benlorenzetti/2015-01-28-Multi-Stage-Tuned-Amplifier/report.pdf

## Multi-Stage Tuned Amplifier

By: Ben Lorenzetti
Team Member: Francois Nyamsi

Project Start Date: January 22, 2015 Report Submission Date: February 8, 2015

## Contents

1 Objective | 1
2 Principles of Operation | 2
3 Theory | 3
4 Design and Simulation | 8
5 Appendices | 12

## 1 Objective

To compare the operation of common-emitter and common-base tuned amplifier stages, and to design and characterize a multi-stage, high-gain IF amplifier for 10 MHz operation with 50Ω input and output impedances.

## 2 Principles of Operation

Tuned amplifiers are critical for electronic communications because they increase the power of desired signal but reject other frequencies as noise. At 10 MHz, a tuned amplifier could be used with an antenna to recieve HF amateur radio from the other side of the world 1
, or
could be used in a computer to recieve 10Base-T ethernet.
There are three possible circuit configurations for bipolar junction transistors (BJT) biased in forward-active mode, based on which terminals are used for input, output, and common reference.

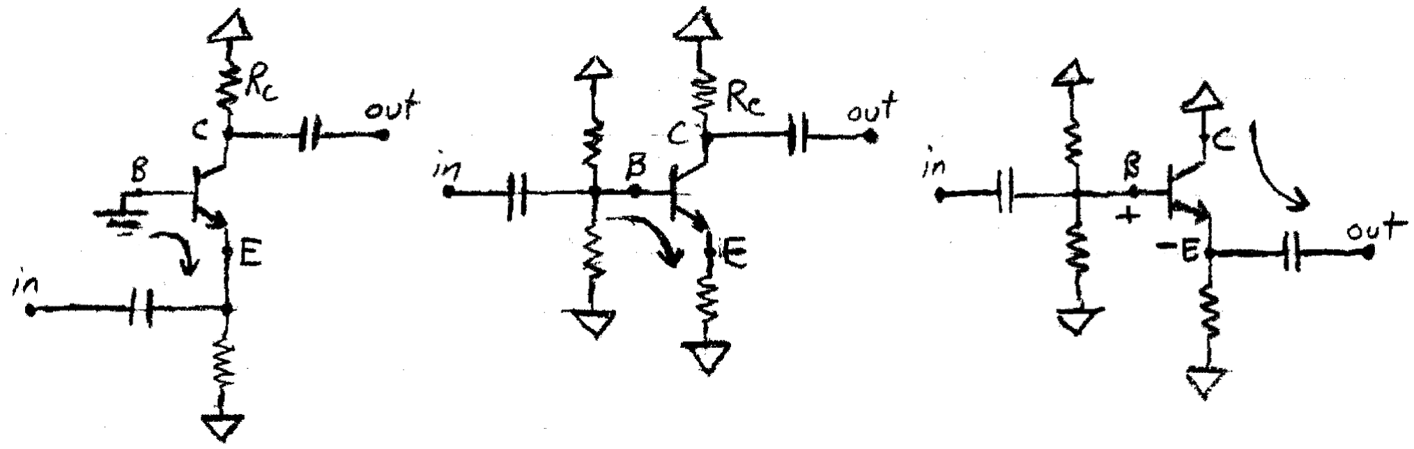
[picture p5: figure]

Figure 1: Common-base (left), common-emitter (middle), and common-collector (right) configurations for BJT amplifiers.

Each configuration has its tradeoffs. The common-base (CB) configuration is a good current buffer, with Ai ≈ 1 and low input impedance. The common-emitter (CE) configuration offers the best overall power gain, but Av and Ai may vary with loadings. The common-collector configuration is a good voltage buffer (Av ≈ 1) with low output impedance.
The three configurations can be cascaded together to gain the benefits of each. If cascaded in the order shown in figure 1, from left-to-right, the resulting 3-stage broadband amplifier would have low input impedance, good power gain, and minimal output impedance.
A slight modification to the CE and CB configurations in figure 1 can apply a filter to the broadband amplifier; tuning the gain to a narrow frequency set by a tank circuit. Because BJTs are minority carrier devices, they act as current amplifiers without being strongly affected by voltage. For the two configurations where the output is at the collector (CB and CE), the BJT acts like a dependent current source feeding the output load and the biasing resistance RC. As a result, the voltage gain for these configurations is determined primarily by how difficult it is for the collector current to reach ground; Av ∝ RC||RL. One can take advantage of the collector current’s obstinance by replacing RC with an impedance that varies with frequency. Using an inductor and a capacitor in parallel provides a short circuit to ground for both DC and high frequency currents. Additionally, at the LC circuit’s resonant frequency, the net impedance → ∞ due to power oscillating between the two. 2 The result is a narrow bandpass filter at the resonant frequency, where ZC → ∞.

1
10 MHz waves can traverse the curve of the earth because they get reflected by charged particles in the ionosphere, called ionospheric skip propagation.
2For this reason, an L||C circuit is called a tank circuit.

## 3 Theory

### 3.1 Tank Circuits

No inductor is ideal. The quality of an inductor is defined by the ratio of the impedance and resistance of the discrete element.

Q =

XL
RS

where ZL = RS + jXL

The series resistance RS is due to the resistivity of the wire and the length used to wrap the coil. Furthermore, the impedance XL is not 100% inductive; there is a distributed capacitance CD between the surfaces of the tightly wrapped wire. The circuit model for an inductor is shown in the left pane of figure 2.
As a consequence of the distributed capacitance, every inductor will have a self resonant frequency f0, at which the energy entering the tank will oscillate between the inductor and capacitor instead of passing through.

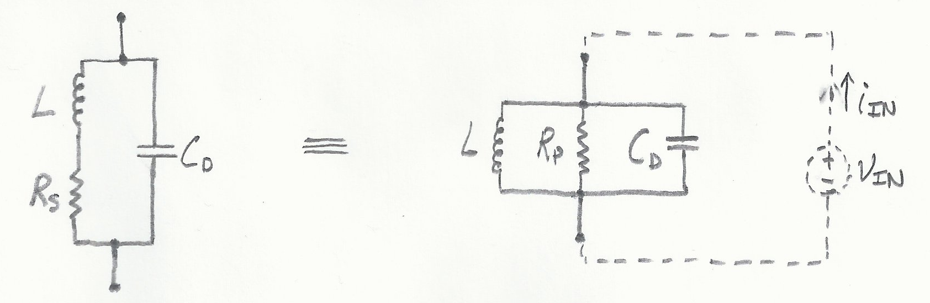
[picture p6: figure]

Figure 2: Circuit model for a non-ideal inductor (left) and its parallel equivalent circuit (right).

Sometimes the parallel equivalent of the imperfect L model is more convenient. If the quality is greater than 5 the conversion is easy:

Q =

XL
RS

=

RP
XL

(1)

The self resonance frequency occurs when the net impedance is greatest. Applying Kirchoff’s current law to the parallel model...

|Iin| =

|Vin|
q
(jωL + 1/jωC)

2 + R²
P

|ZL| =

s
R²
P −
ωL −

1

ωC 2
(2)

One can see that ZL will reach its peak when:
ωL −

1

ωC
= 0

Therefore, the maximum impedance of a tank circuit is:

|ZL|max = RP | when | f0 =

1
2π

√
LC

(3)

More generally than non-ideal inductors; the resonant frequency, bandwidth, and quality of a parallel RLC circuit are related to L, C, and R.

Q =

ω0
B
| = ω0RC = | R ω0L
(4)

### 3.2 Common-Base Broadband Amplifier

The basic circuit for an single stage, common-base (CB) amplifier is shown in figure 3. The base terminal is grounded and the input signal passes through the BJT from emitter to collector. In this configuration, the BJT acts like a current buffer, where the input current is repeated at the output regardless of the load.

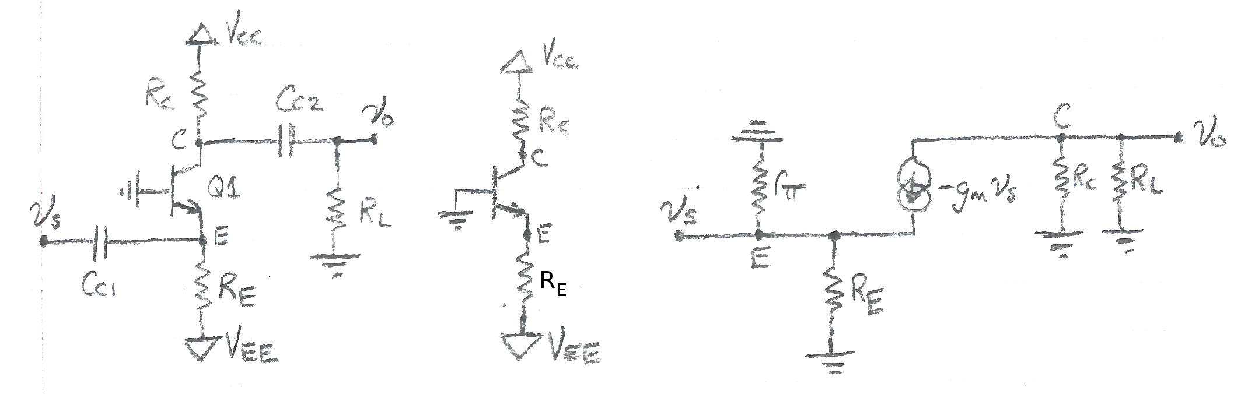
[picture p7: figure]

Figure 3: Basic circuit for a common-base broadband amplifier (left), its DC large signal (middle) equivalent, and AC small signal equivalent (right).

Two DC power rails are needed to bias the BJT in forward-active mode. A positive supply holds the collector reverse biased relative to the base which, at ground, is forward biased relative to the negative supplied emitter. Quiescent point analysis of the common-base is easy because the voltage is pinned at every node.

IEQ =

−VBE(on) − VEE
RE

(5)

rπ =

Vth

IBQ

=

(β + 1)Vth

IEQ

(6)

gm =

β
rπ

=

αIEQ

Vth

(7)

The hybrid-π model for small signal AC modeling is shown in the right pane of figure
3. Applying Kirchoff’s current law at node E can be used to find the input resistance.

KCL @ E: iS −

vs
rπ

−

vs
RE

− gmvs = 0

is = vs

1
Rπ

+

1
RE

+ gm

is = vs

RE + rπ + gmrπRE
rπRE

vs
is

=

rπRE
RE + rπ + gmrπRE

Rin =

rπ
β + 1 + rπ
rE

Rin =

rπ

β + 1
1

1 + rπ/(β+1)RE

(8)

Applying KCL at the collector can be used to calculate the voltage gain of a single common-base stage.

KCL @ C: gmvs +

vo
RL

+

vo
RC

= 0

vo

RL + RC
RLRC
= gmvs

Av =

gmRLRC
RL + RC

(9)

### 3.3 Common-Emitter Broadband Amplifier

The basic circuit for an single stage, common-emitter (CE) amplifier is shown in figure 4. The DC equivalent circuit is shown in the left pane of figure 5; the AC in the right.

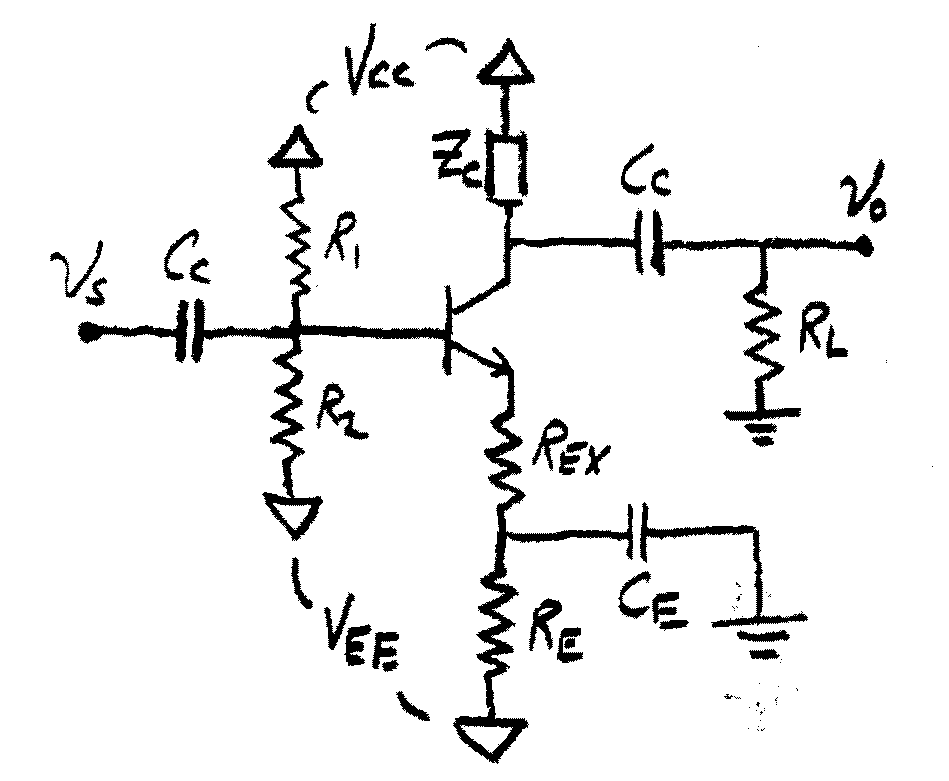
[picture p8: figure]

Figure 4: Broadband Common-Emitter Stage

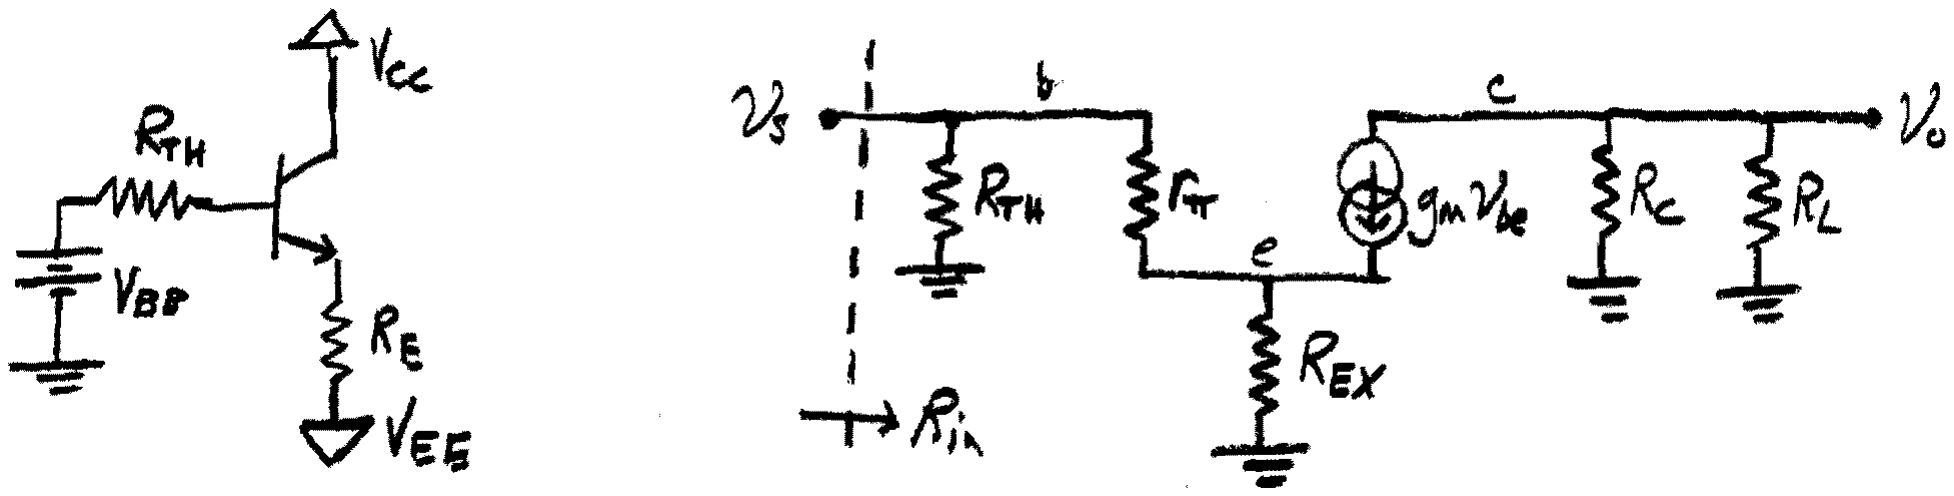
[picture p9: figure]

Figure 5: Common-emitter equivalent circuits: DC (left), AC (right).

The DC equivalent circuit, shown in figure 5, used a thevenin source conversion from the base bias resistors R1 and R2. The thevenin equivalent’s parameters are found by

RT H = R1||R2 =

R1R2
R1 + R2

(10)

and
VBB = VEE +

R2
R1 + R2
(VCC − VEE) | (11)

The same thevenin conversion was used for the AC circuit in figure 5 for RT H. The other parameters in the AC equivalent circuit come from the hybrid-π model, defined previously in equations 6 and 7.
The DC loading characteristics are easily found by using KVL on the collector-emitter loop.

VCC − VCE − REIEQ − VEE = 0

IE =

VCC − VEE
RE

−

VCE
RE

(12)

The AC characteristics require a little more algebra. We are interested in the small signal voltage gain and input resistance for a CE stage. Kirchoff’s current law at the emitter node of the AC equivalent circuit (figure 5, right pane) can be written:

ve − vs
rπ

+

ve

REX

+ gm(ve − vs) = 0

Collecting terms and separating variables gives:

ve

1
rπ

+

1

REX

+ gm

= vs
1
rπ

+ gm

Multiplying both sides by rπ and REX gives:

ve[REX(1 + β) + rπ] = vs(1 + β)REX

So the ratio between ve and vs is:

ve
vs

=

(1 + β)REX
(1 + β)REX + rπ

Looking ahead, in the interest of saving paper, it would be better to have an expression for vs − ve as a function of vs.

vs − ve = vs

1 −

ve
vs
= vs
1 −

(1 + β)REX
(1 + β)REX + rπ

vs − ve =

rπ
(1 + β)REX + rπ
vs | (13)

The small signal voltage gain can be found from Ohm’s law, applied across the resistors between the output and ground.

vo = (RC||RL) ∗ gm(vs − ve)

Substituting equation 13 for the voltage difference and then recognizing that rπgm = β...

vo = (RC||RL)

β
(1 + β)REX + rπ
vs

Dividing both sides by vs and pulling α out of the bracket gives us the magnitude of the transfer function in generic form.

Av =

(RC||RL)

REX

∗

β
β + 1

∗

1

1 + rπ/(β+1)REX

(14)

Now for the small-signal input resistance; the ratio between vs and is in for the AC equivalent circuit in figure 5. Writing KCL at the base node yields

−is +

vs

RT H

+

vs − ve
rπ

= 0

Substituting equation 13 for vs−e eliminates ve

is =

vs

RT H

+

vs
rπ
rπ
(1 + β)REX + rπ

Dividing both sides by vs gives the input conductance, but the partial fractions must be prepared for inversion.

Gin =

1

RT H

+

1
(1 + β)REX + rπ
=
(1 + β)REX + rπ + RT H
RT H(REX(1 + β) + rπ)

Inverting the conductance and pulling (1 + β)REX + rπ out of both numerator and denominator gives the input resistance in generic form.

Rin = RT H
1

1 + RTH/(1+β)REX+rπ

If one assumes that RT H >> (1 + β)REX + rπ, then the +1 term in the denominator is negligible and the input resistance simplifies to

Rin = (1 + β)REX + rπ | (15)

### 3.4 Voltage Gain and IEQ

Substituting equation 7 for gm into equation 9 gives voltage gain of a CB amplifier as a function of quiescent current. Similaryly, substituting equation 6 for rπ into equation 14 gives the small-signal gain of a CE amplifier.

Av(CB) =

α(RL||RC)IEQ

Vth

(16)

Av(CE) =

α(RC||RL)

REX
1

1 + Vth/REXIEQ
(17)

Using typical resistor values, the small-signal gain of broadband common-base and common-emitter amplifiers was plotted as a function of DC biasing. The MATLAB script used to generate plot 6 is included in appendix 5.3.

Figure 6: Relationship Between AC Voltage Gain and DC Biasing for CB and CE Amplifier

### 3.5 Coupling Capacitors

The coupling capacitors, labeled CCx, isolate each stage from direct currents but provide a low impedance path for the AC signal. Taken together, they should form a sharp high-pass filter with its corner frequency below 1000 Hz. The 3dB corner occurs when half the signal power is dissipated in the capacitor and half in the stage’s input. This occurs when ZCc = Zin.

1
|jωC|

= Rin

CC ≥

159.15 µF ∗ Ω

Rin

(18)

## 4 Design and Simulation

### 4.1 Specifications

The multi-stage amplifier must meet the following specifications in table 1.

Table 1: Lab Specifications

power supply | ±12V
passband center frequency | 10MHz
bandwidth | 300kHz
input impedance | 50Ω
ouptut impedance | 50Ω
gain at center frequency | > 60dB

### 4.2 BJT Characterization

Four npn 2N2904 BJTs were characterized using the Tektronix curve tracer and an HP LCR meter. The results are shown in table 2. The current amplification factors (β or hfe) were taken with DC biasing close to their designed use; the actual IC − VCE characteristic curves appear later, as the DC design is described.

Table 2: Measured BJT Characteristics

| Q1 | Q2 | Q3 | Q4
β | 181 | 191 | 189 | 189
VA | 260V | 273V | 273V | 224V

CCB

3 | 5.1pF | 5.19pF | 5.18pF | 5.23pF
CBE | 3.26pF | 3.28pF | 3.30pF | 3.24pF

### 4.3 Tank Circuits

Two inductors were wound with ˜22 turns. Their inductance and quality were measured using a Hewlett-Packard 4342A Q Meter. An appropriate discrete capacitor and trimming capacitor were selected for both to obtain a tank circuit with resonance at 10 MHz. The fixed capacitors were soldered to their inductors in parallel.
The soldered LC circuit were breadboarded in parallel with a trimming capacitor and tuned. Then, the breadboarded tank circuit was measured for net capacitance, resonance frequency, and quality using the HP Q Meter. The methods for these measurements are attached in appendix 5.1 and the results are shown in table 3.

Table 3: Tank Circuit Design and Measured Characteristics

Parameter | 1 | 2 | Description
L | 4.2µH | | measured inductor
QL | | | on HP Q Meter
Ctarget | 90 | | from eq. 3.1
Cf ixed | 33pF | | nominal value
Ctrim | 5 − 35pF | | approx. range
Cd | 55pF | | measured LC circuit
f0 | 13.3MHz | | on HP Q Meter,
Q | 85.5 | | see 5.1
Rp | 30kΩ | | from eq. 4

### 4.4 Common-Base Stage

The first stage must be a common-base amplifier in order to achieve low input resistance. The emitter resitance must be chosen to achieve desirable input resistance and voltage gain.

3measurement taken at 10MHz

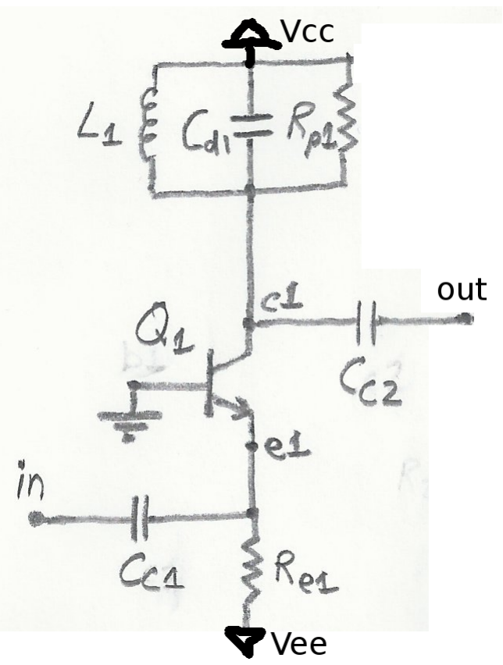
[picture p10: figure]

Figure 7: Common-base stage with SPICE netlist labels.

It is clear that Rin is strongly related to rπ from equation 8. Substituting equation ?? for rπ into equation 8 yields

Rin =

−VthRE

VBE(on) + VEE

or
RE =

Rin(−VBE(on) − VEE)
Vth |

Using the specified value for VEE and Rin, and typical values for Vth and VBE(on) , the
emitter resitance should be

RE =

50Ω(−0.7V + 12V )
0.0259V

= 21.8kΩ

With RE, the quiescent current can be calculated with equation 5; IEQ = 0.52mA. The first BJT was characterized and a DC load line drawn. Because all of the node voltages are pinned, the load line is vertical; VCE is independent of IEQ. It was found that

βQ1 = 176 | VAQ1 = 452V

From equation 18 and using Rin = 50Ω,

CC1 ≥ 3.183pF

At this point, all of the discrete components for the CB stage have been determined. A SPICE simulation was performed to check the performance of the stage. For a load value, the input resistance of the first common emitter stage was used. The netlist used is included in appendix 5.2 and the results are shown in figure 9.

### 4.5 Common-Emitter Stage

The common-emitter configuration provides the highest overall power gain, compared to CB and CC. This makes it ideal for the middle stages. A single CE stage is shown in figure ??.
The second BJT was characterized on the Tektronix Curve Tracer using a range of 20V and 2mA (the maximum swing would actually be 24V). The i-v characteristics and the DC

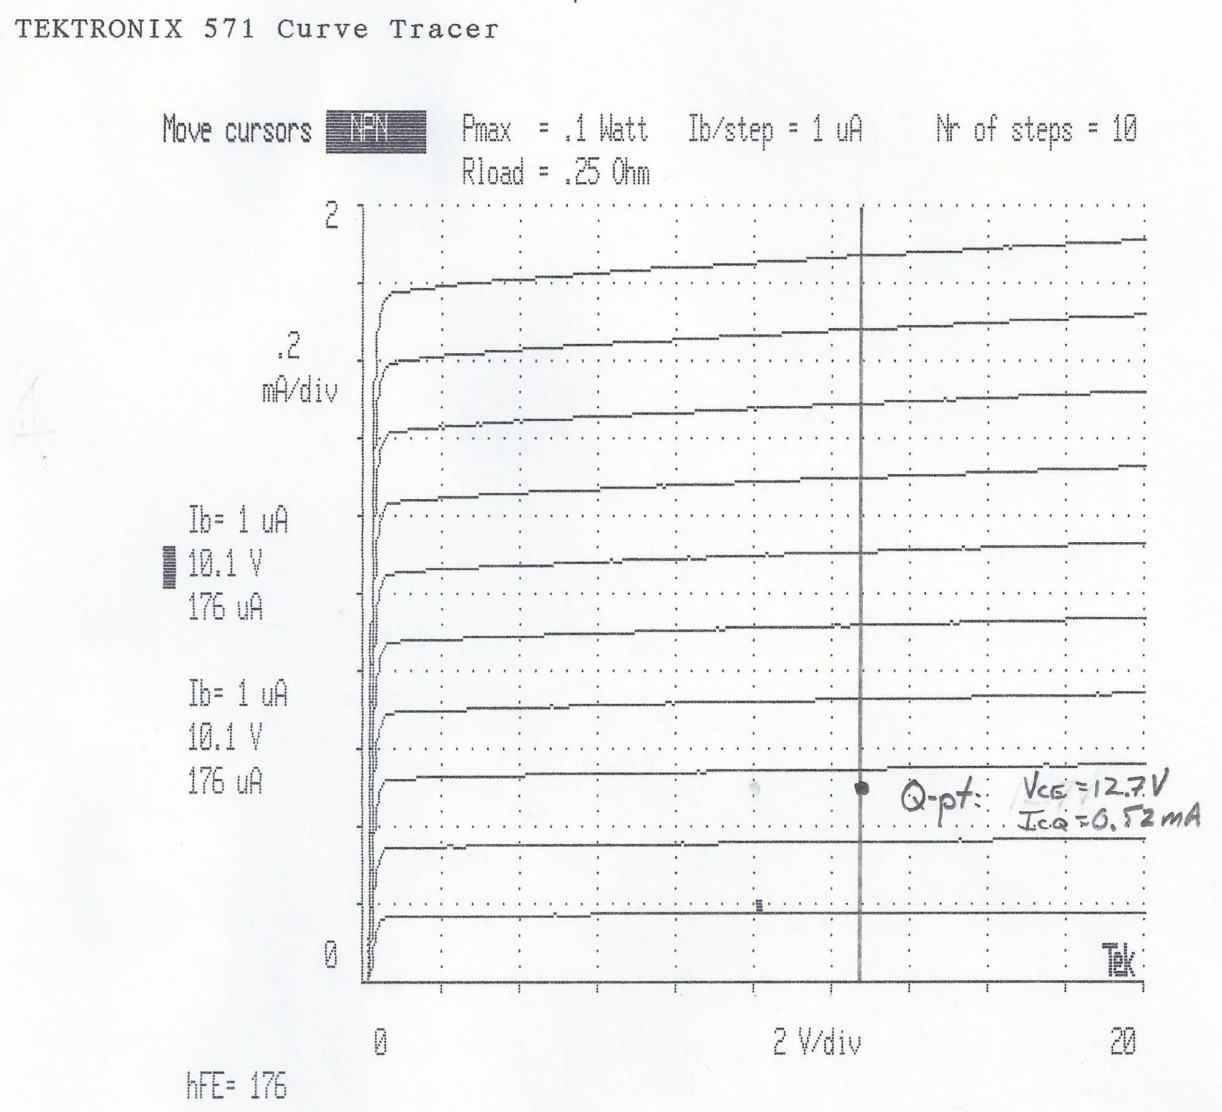
[picture p11: figure]

Figure 8: Q1 Current-Voltage Characteristics and DC Load Line

load line are shown in figure 10. It was found that

βQ2 = 192 | and | VA(Q2) = 228V

The MATLAB analysis of Av(IEQ) in section 3.4 showed that the gain of a CE amplifier grows proportionally to the quiescent current. Based on this, a relatively large quiescent current was chosen, 1.92mA.
The Q-point should lie at exactly the middle of the two supplies to allow the maximum possible voltage swing; so VCEQ = 12V . Putting the desired Q-pt. into equation 12 determined the required emitter resistance.

RE2 =

VCC − VEE − VCEQ
IEQ | | = 12V 1.92mA = 6.25kΩ

The value of RT H should be at least 10 times the emitter resistance to ensure a stiff base bias. 4 Therefore,
RT H = 62.5kΩ = R1||R2

If VCEQ is 12V, then the base must be biased at +0.7V to forward bias the base-emitter junction. The base resistors form a voltage divider between VCC and VEE to achieve this.

0.7V = | R2 R1 + R2 | (24V ) − 12V

Solving the voltage divider equation with the definintion of RT H gives us values for R1 and R2.
R1 = 177.2kΩ | R2 = 96.6kΩ

4A stiff base means that R1 and R2 behave like a voltage divider, with negligible current being diverted into the base.

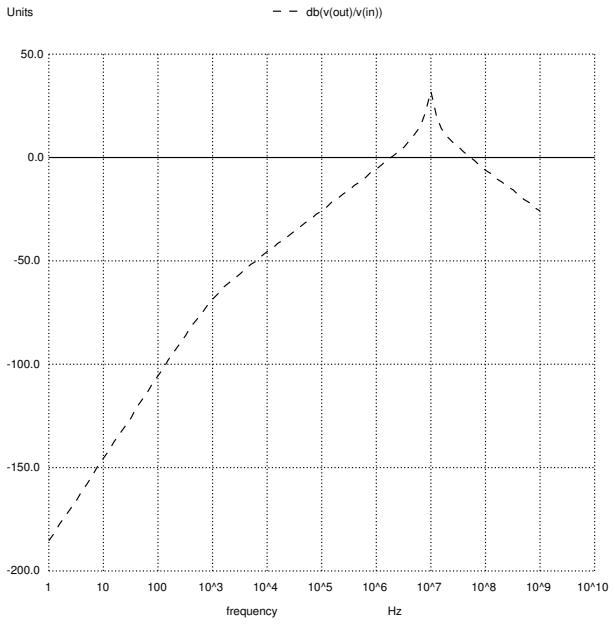
[picture p12: figure]
frequency; Units; db(v(out)/v(in))

Figure 9: Magnitude Gain of Common-Base Stage, in dB

## 5 Appendices

### 5.1 HP 4342A Q Meter

The following 3 pages are taken from the HP 4342A Q Meter Operating and Service Manual, pages 35-37.

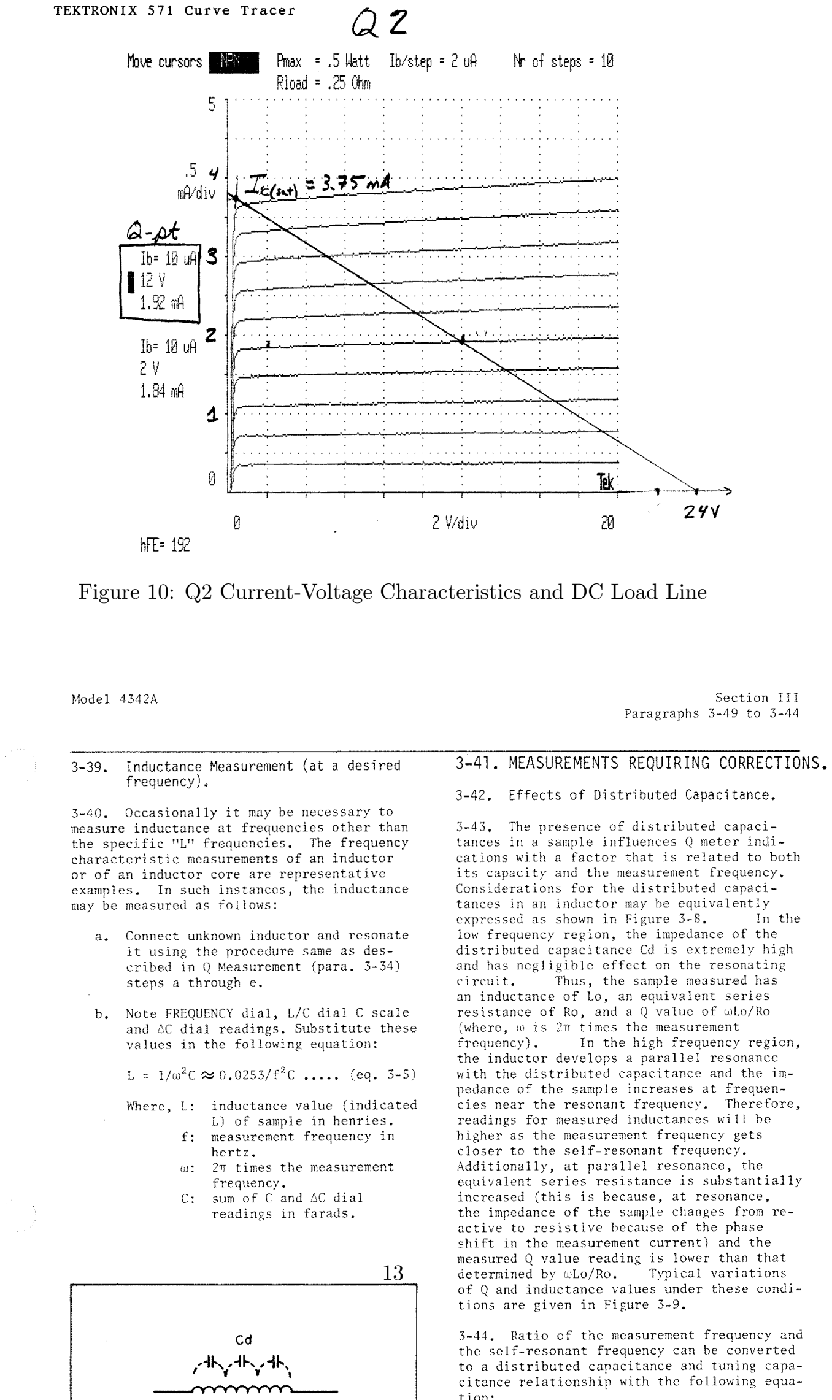
[picture p13: page 15]

Figure 10: Q2 Current-Voltage Characteristics and DC Load Line



### 5.2 Common-Base SPICE Netlist

The following netlist was used to simulate the CB stage. The labeling in the netlist corre-sponds to the circuit in figure 7.

*** CBstage.cir ***
* Nodes:
* gnd, cc (+12V), ee (-12V), s, in, e1, c1, out

Vcc cc gnd dc 12V ac 0V
Vee ee gnd dc -12V ac 0V
Vs s gnd dc 0V ac 10mV
Rs in s 50
Cc1 in e1 3.183uF
Re1 e1 ee 21.8k
Q1 c1 gnd e1 model1
L1 c1 cc 4.2uH
Cd1 c1 cc 55pF
Rp1 c1 cc 2.18k
Cc2 c1 out 3.183uF
Rld out gnd 9999k

* .model <name> <type> (par1=value1 par2=value2 ...) * VAF = forward Early voltage
* BF = forward beta; forward common-emitter gain
* CJE = base-emitter zero-bias junction capacitance * CJC = base-collector zero-bias junction capacitance * TS = transport saturation current
* NF = forward mode ideality factor

.model model1 npn (BF=176 CJC=20pf CJE=20pf IS=1E-16 VAF=452V NF=1)

.control
set filetype=ascii
ac dec 10 1Hz 1GHz
plot db(v(out)/v(in))
plot ph(v(out))-ph(v(in))
write CBstage.txt db(v(output)/v(input)) ph(v(output))-ph(v(input))

### 5.3 MATLAB Script for Av(IEQ)

PUT CODE HERE!
