benlorenzetti/2015-01-28-Multi-Stage-Tuned-Amplifier/ngspice/CBstage-eps-converted-to.pdf

Units | db(v(out)/v(in))

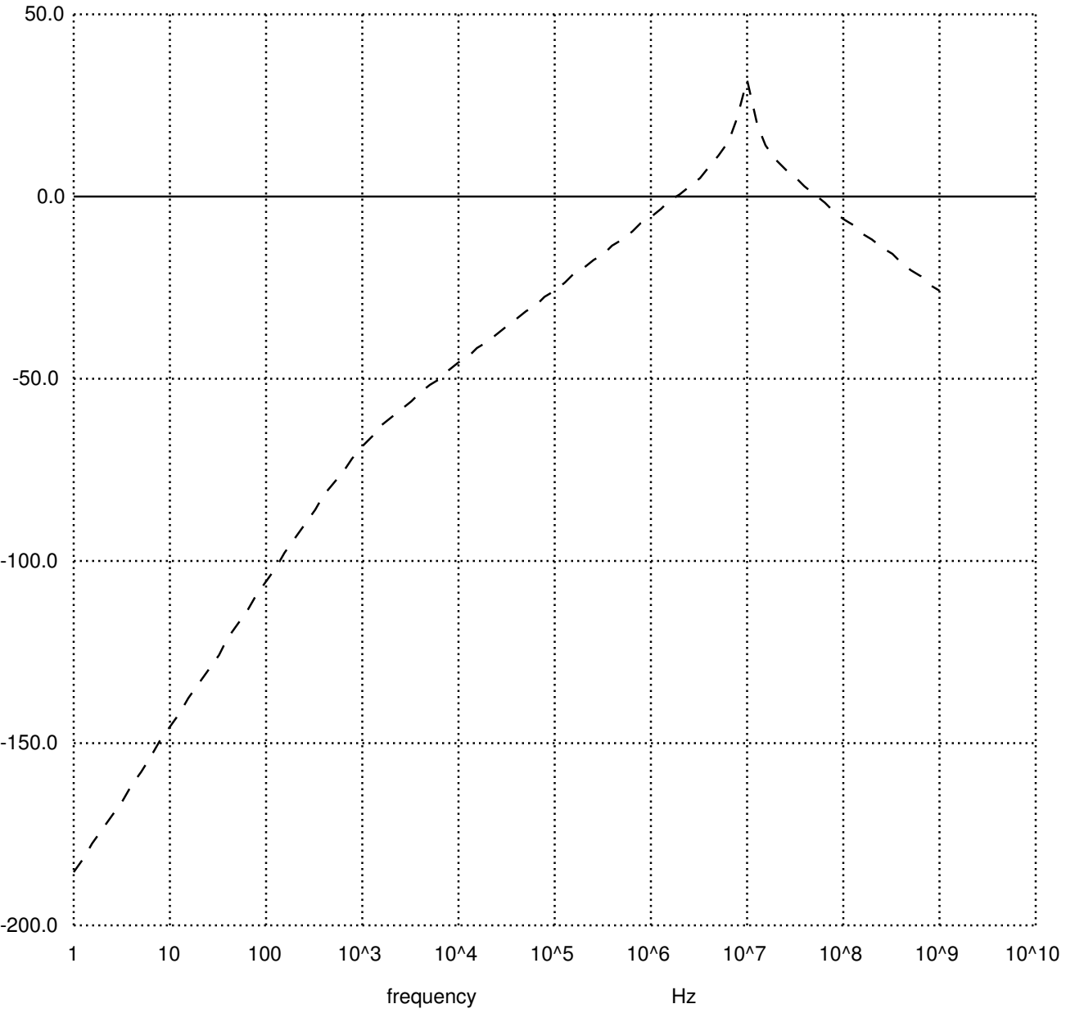
[picture p14: figure]
frequency
