benlorenzetti/2015-01-28-Multi-Stage-Tuned-Amplifier/figures/commonBaseStage.png

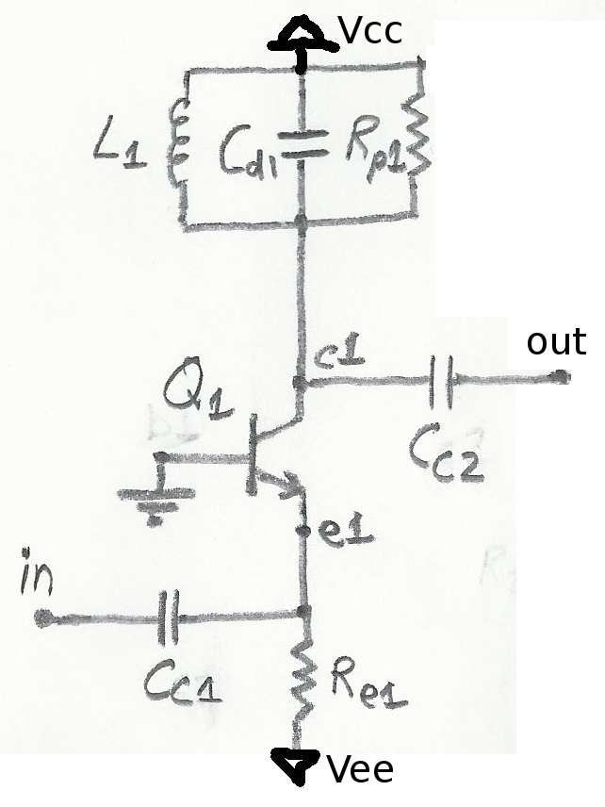
figures/commonBaseStage.png
