benlorenzetti/2015-01-28-Multi-Stage-Tuned-Amplifier/figures/commonCollectorAmplifier.png

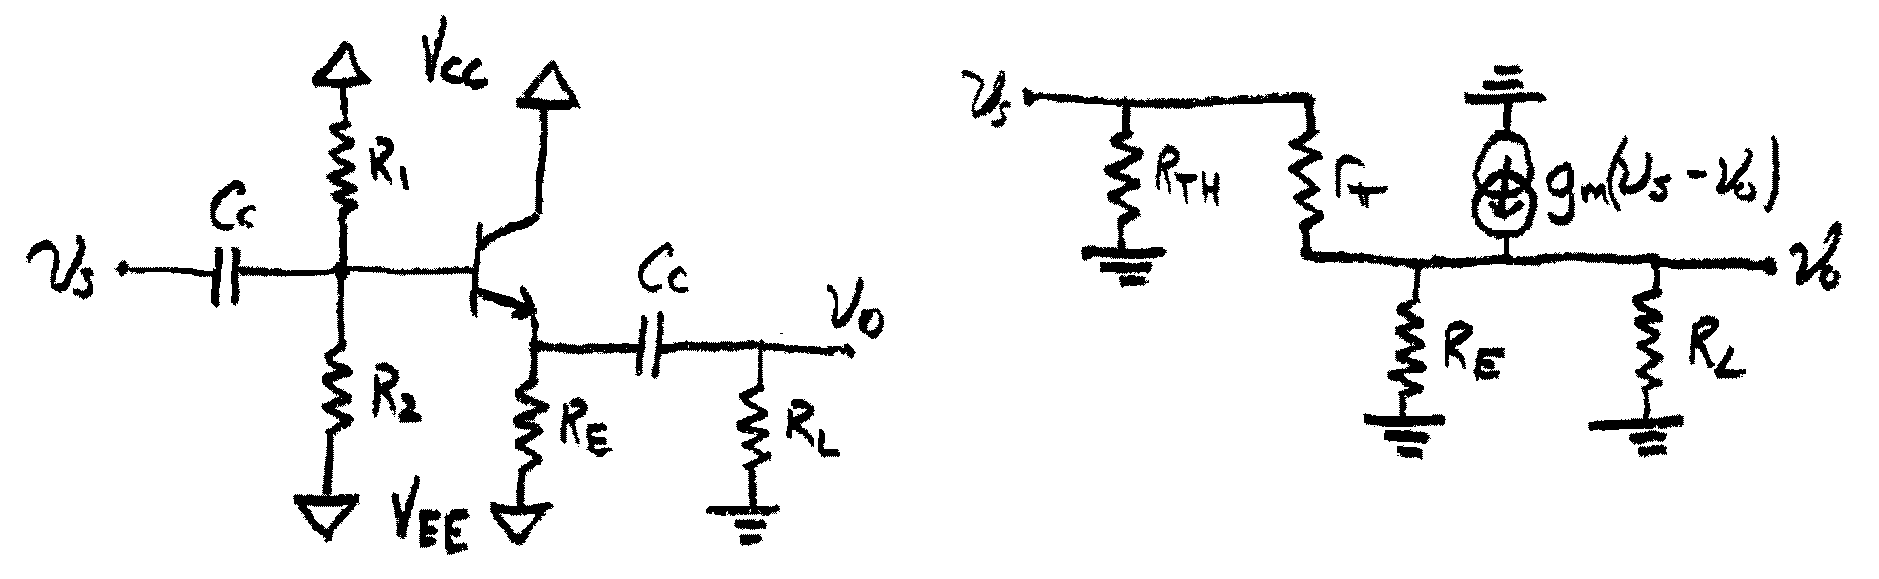
figures/commonCollectorAmplifier.png
