benlorenzetti/2015-01-28-Multi-Stage-Tuned-Amplifier/figures/commonCollectorCircuit.png

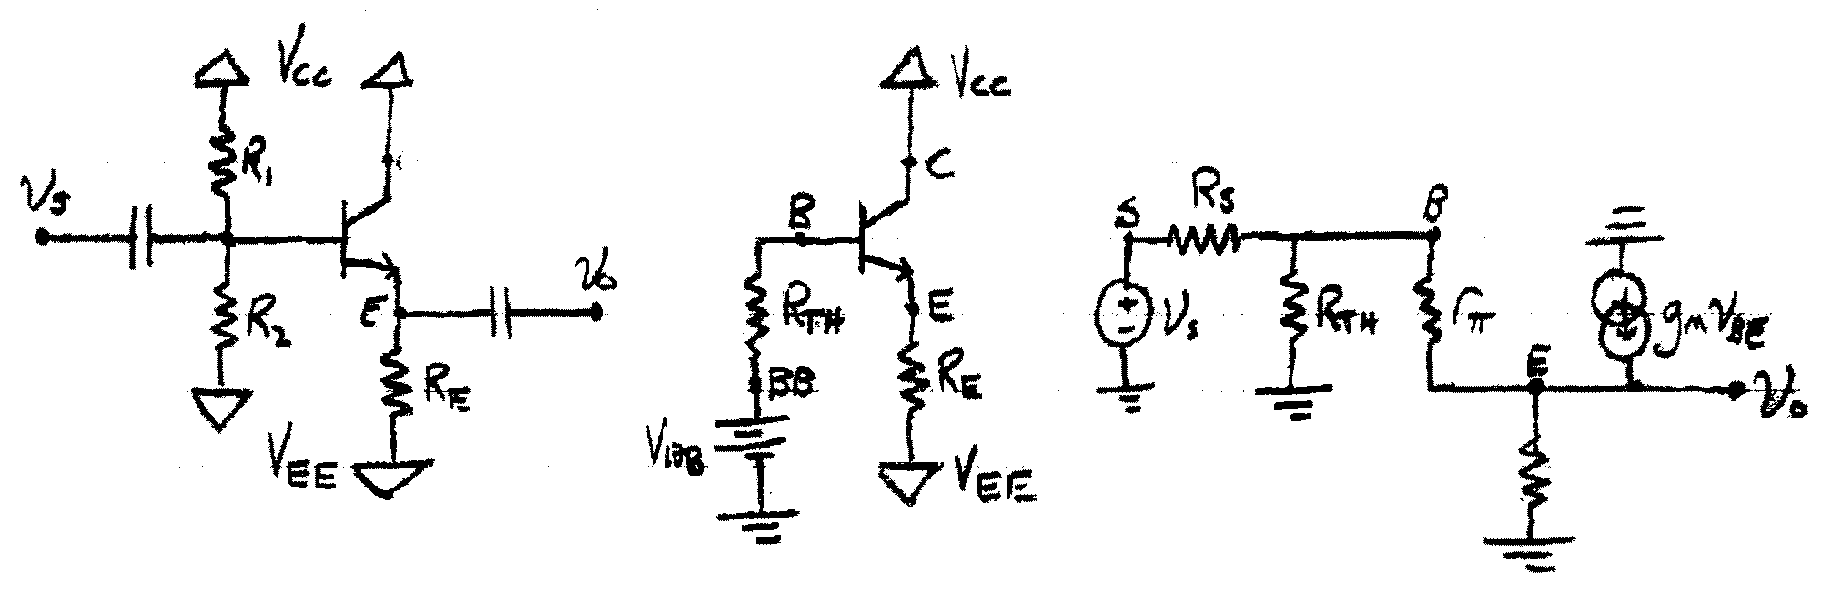
figures/commonCollectorCircuit.png
