benlorenzetti/2015-01-28-Multi-Stage-Tuned-Amplifier/figures/commonEmitterACcircuit.png

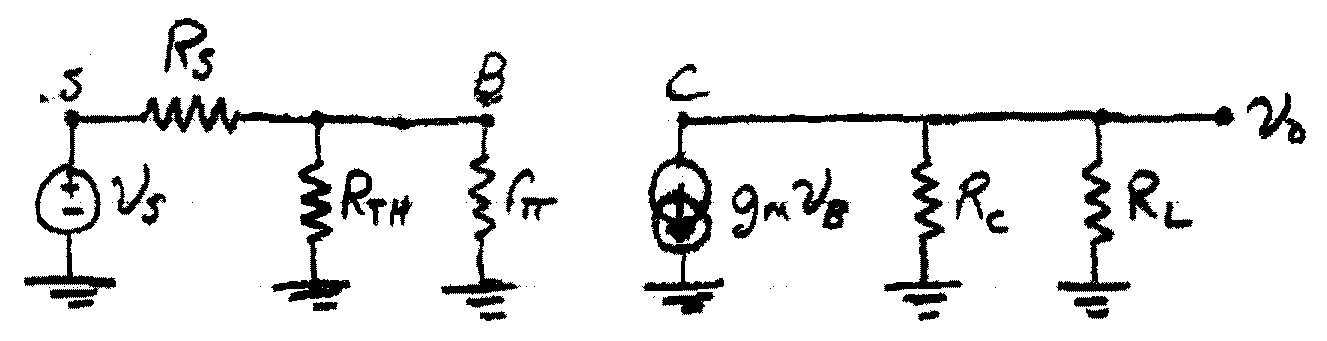
figures/commonEmitterACcircuit.png
