benlorenzetti/2015-01-28-Multi-Stage-Tuned-Amplifier/figures/commonEmitterDCcircuit.png

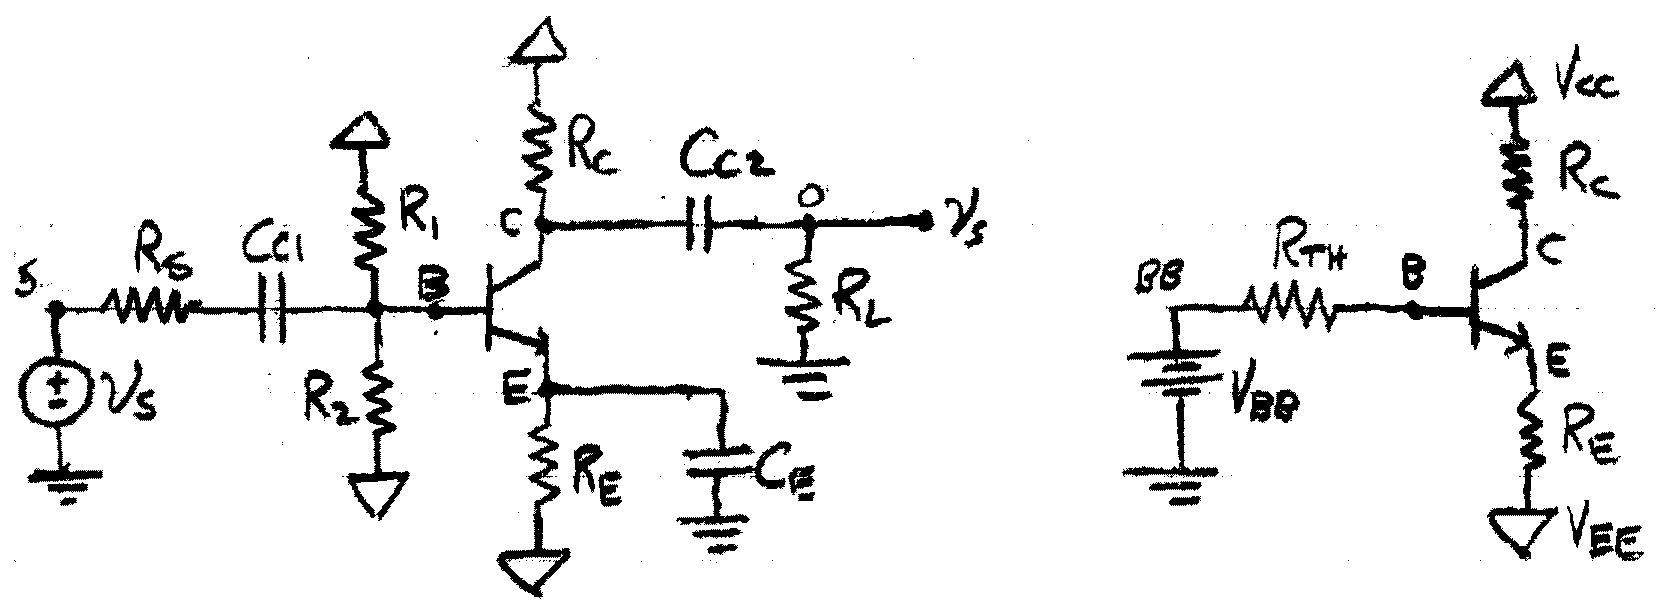
figures/commonEmitterDCcircuit.png
