benlorenzetti/2015-01-28-Multi-Stage-Tuned-Amplifier/figures/commonEmitterEquivalentCircuits.png

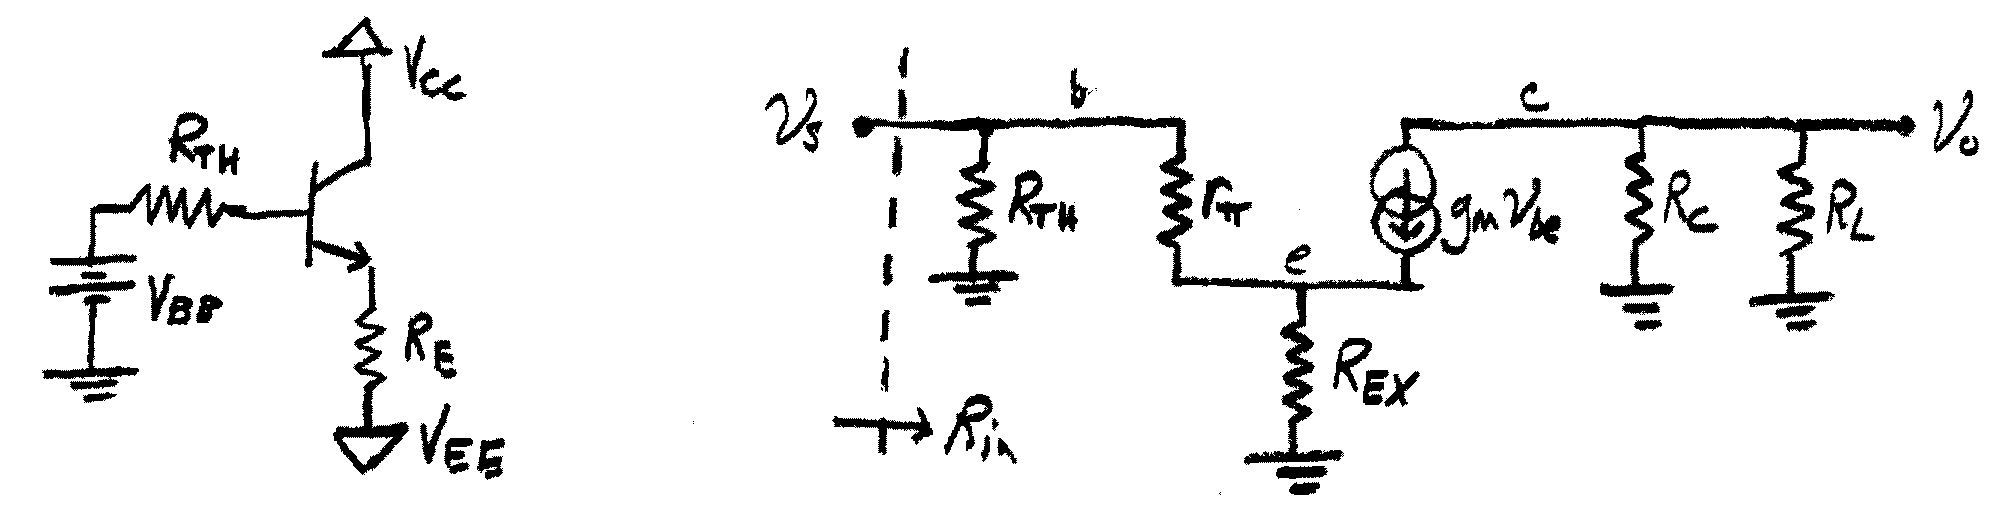
figures/commonEmitterEquivalentCircuits.png
