benlorenzetti/2015-01-28-Multi-Stage-Tuned-Amplifier/figures/commonEmitterStage.png

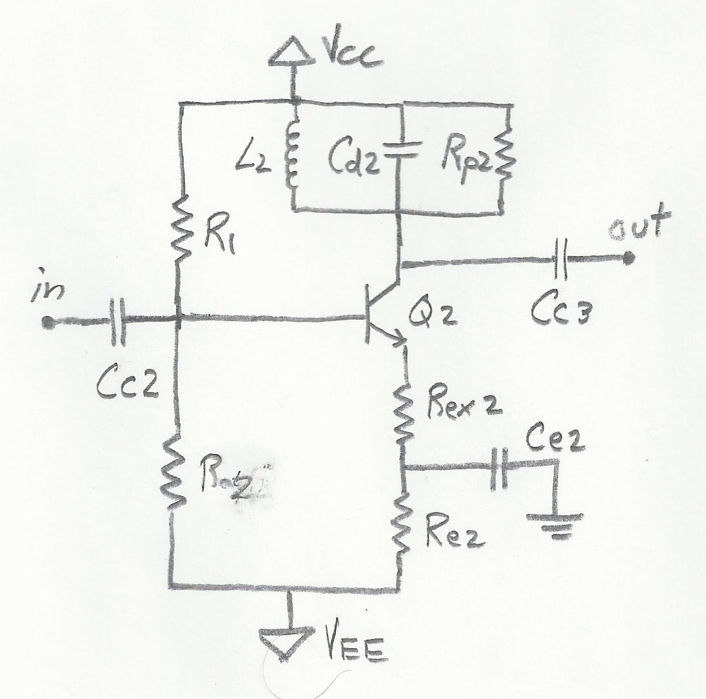
figures/commonEmitterStage.png
