benlorenzetti/2015-01-28-Multi-Stage-Tuned-Amplifier/figures/multiStageTunedAmplifier.png

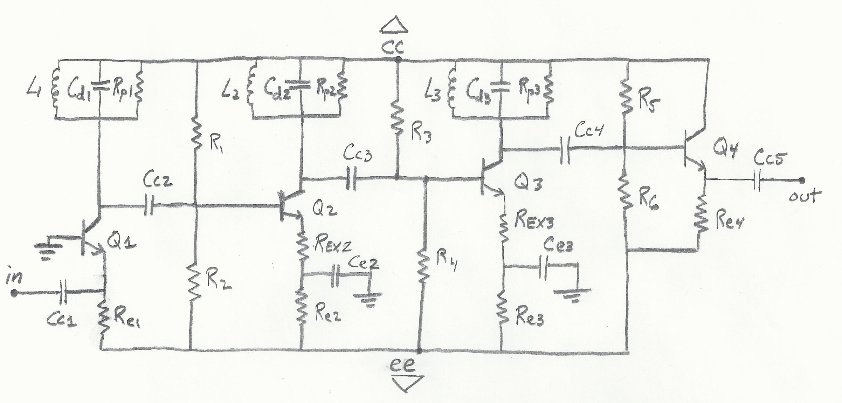
figures/multiStageTunedAmplifier.png
