benlorenzetti/2015-01-28-Multi-Stage-Tuned-Amplifier/images/CBat10e6.png

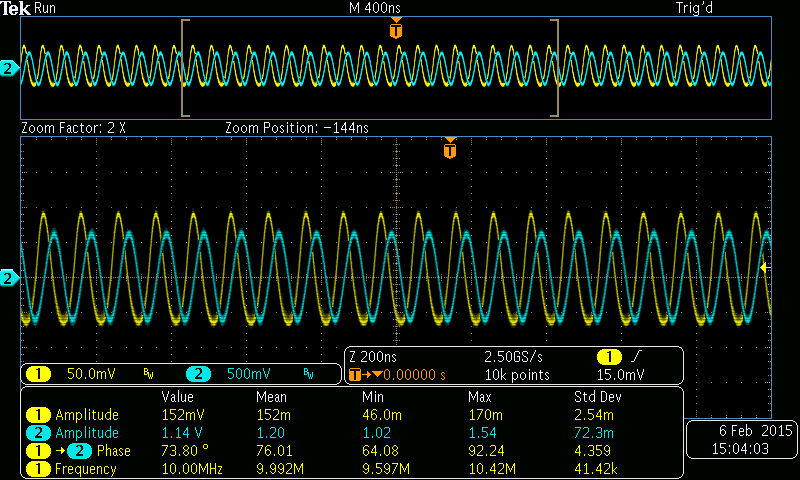
images/CBat10e6.png
