benlorenzetti/2015-01-28-Multi-Stage-Tuned-Amplifier/images/CBat94e6.png

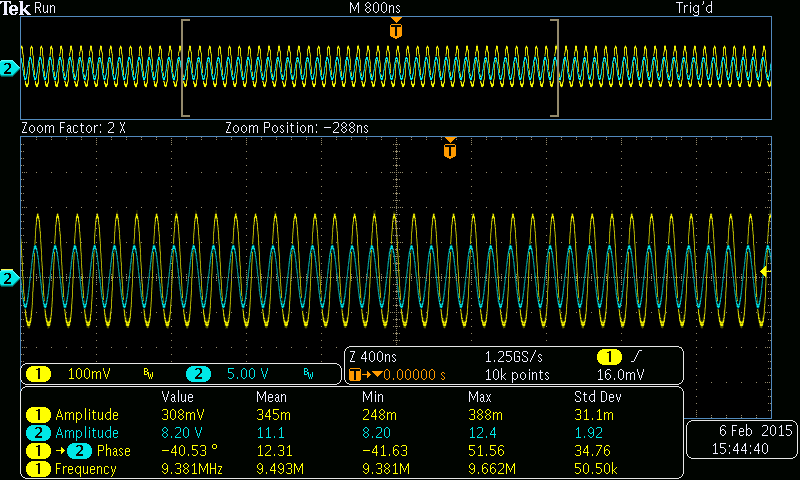
images/CBat94e6.png
