benlorenzetti/2015-01-28-Multi-Stage-Tuned-Amplifier/images/CBat95e6.png

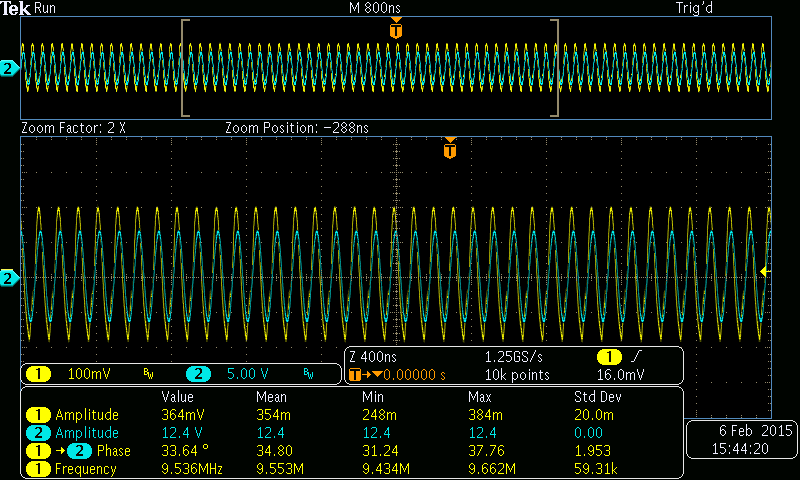
images/CBat95e6.png
