benlorenzetti/2015-01-28-Multi-Stage-Tuned-Amplifier/images/CBat96e6.png

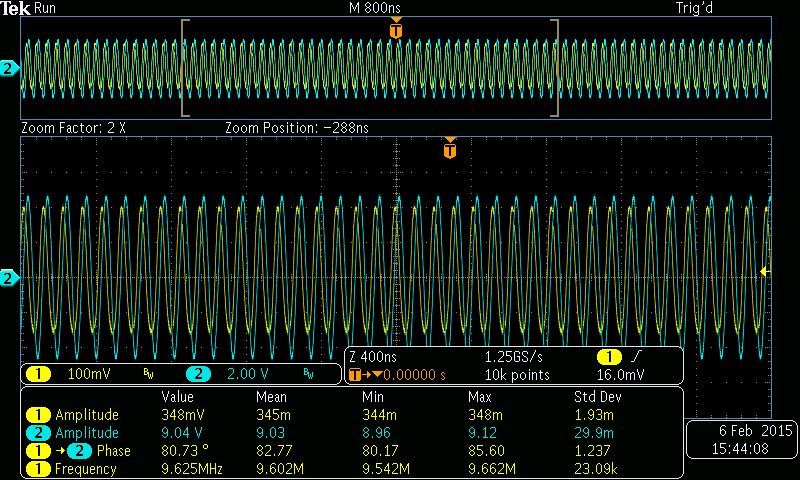
images/CBat96e6.png
