benlorenzetti/2015-01-28-Multi-Stage-Tuned-Amplifier/images/CBstage.jpeg

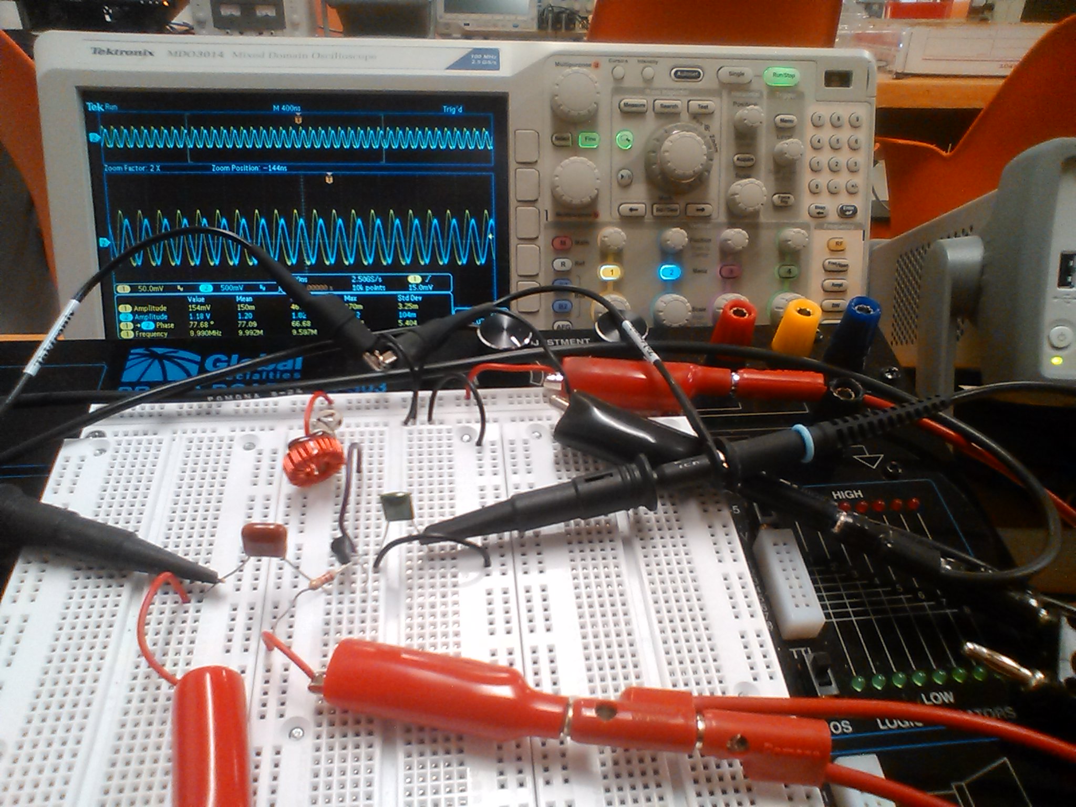
images/CBstage.jpeg
