benlorenzetti/2015-01-28-Multi-Stage-Tuned-Amplifier/images/CEbestStabeGain.png

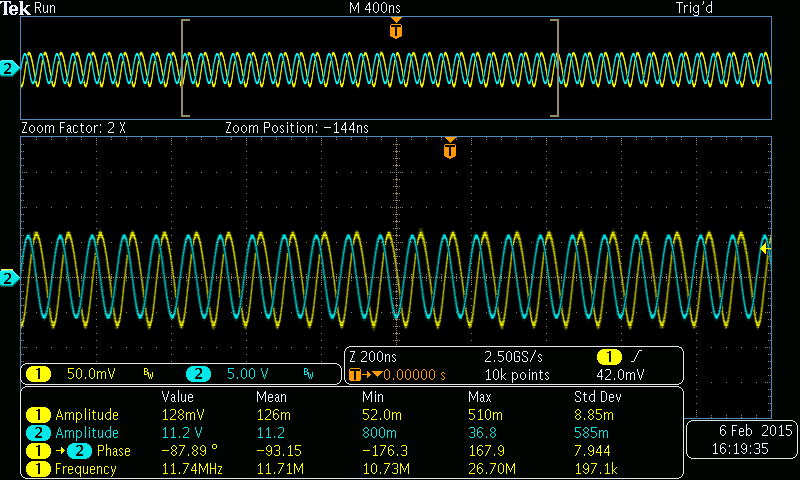
images/CEbestStabeGain.png
