benlorenzetti/2015-01-28-Multi-Stage-Tuned-Amplifier/images/CEhighFreqStableGain.png

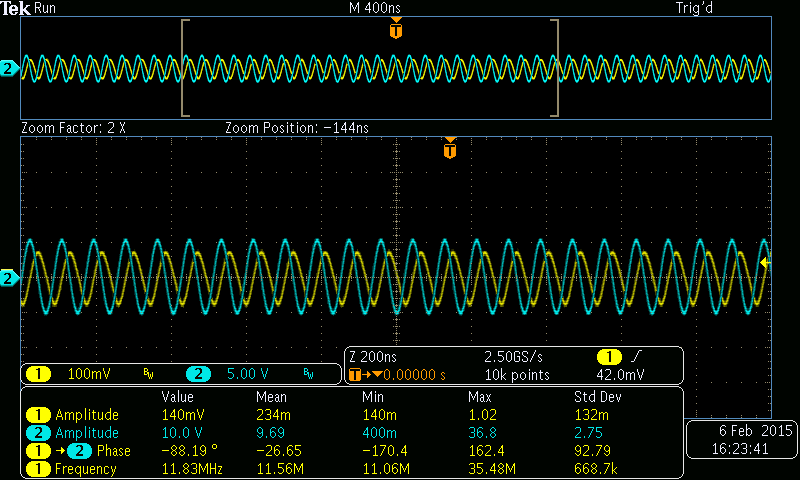
images/CEhighFreqStableGain.png
