benlorenzetti/2015-01-28-Multi-Stage-Tuned-Amplifier/images/CElowFreqStableGain.png

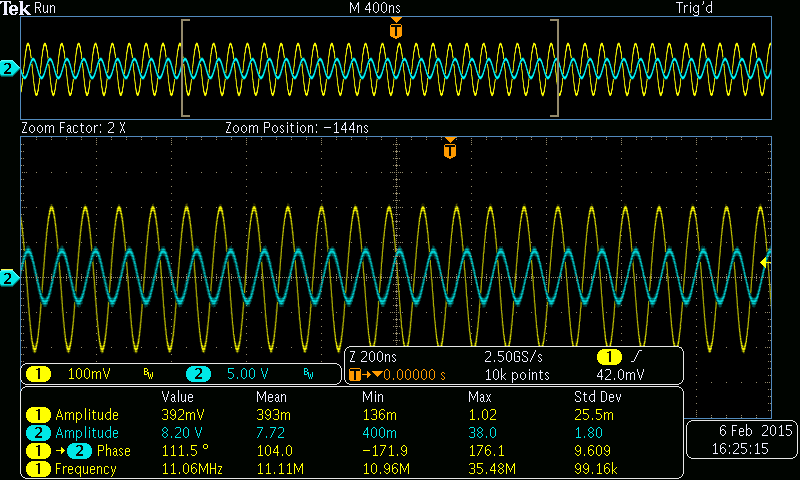
images/CElowFreqStableGain.png
