benlorenzetti/2015-01-28-Multi-Stage-Tuned-Amplifier/images/CEstage.jpeg

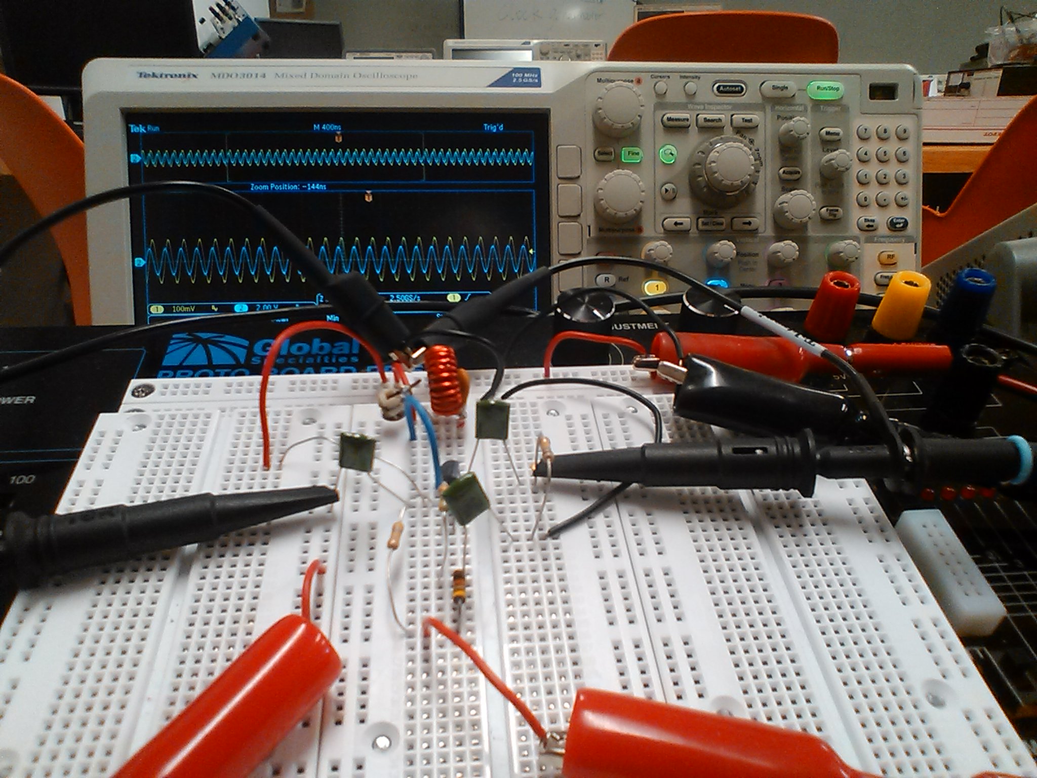
images/CEstage.jpeg
