benlorenzetti/2015-01-28-Multi-Stage-Tuned-Amplifier/images/multiStage.jpeg

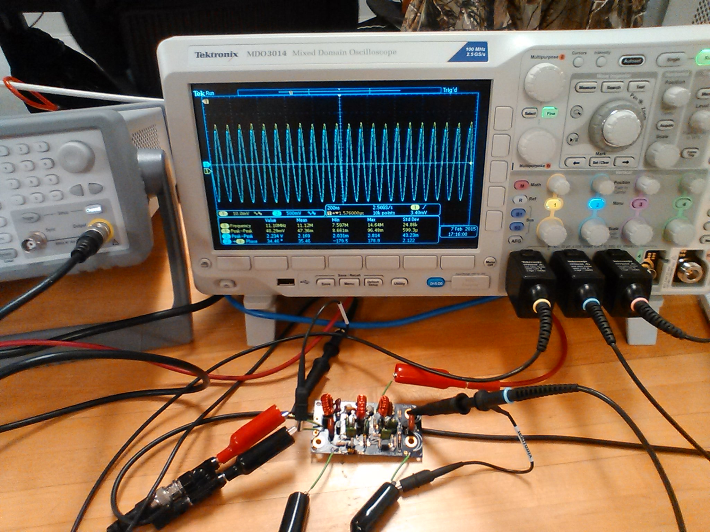
images/multiStage.jpeg
