benlorenzetti/2015-01-28-Multi-Stage-Tuned-Amplifier/images/multiStageEagleBoard.PNG

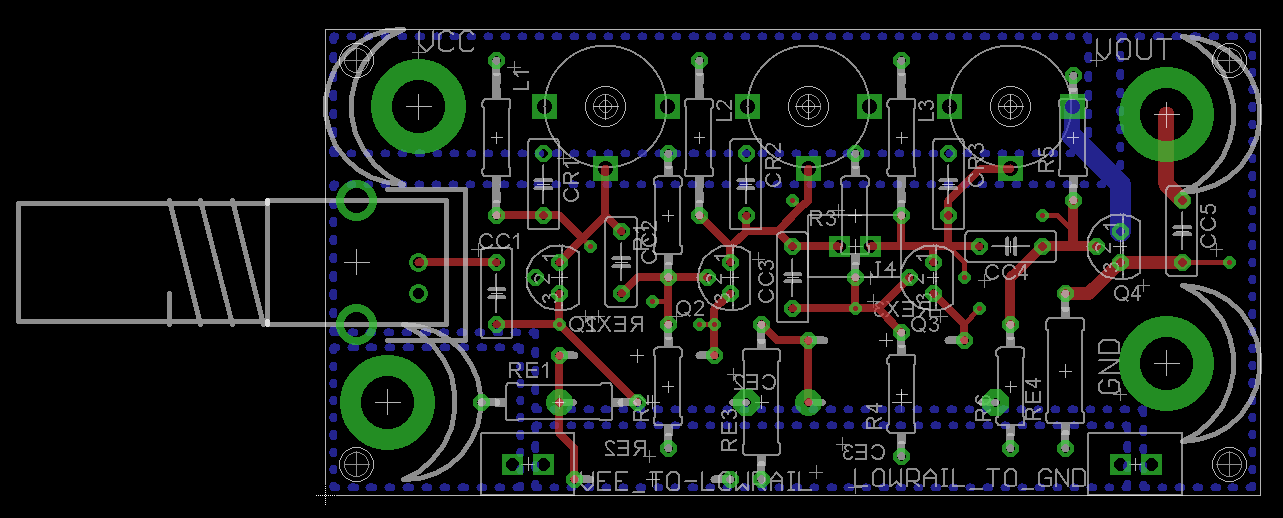
images/multiStageEagleBoard.PNG
