benlorenzetti/2015-01-28-Multi-Stage-Tuned-Amplifier/images/multiStageEagleCircuit.PNG

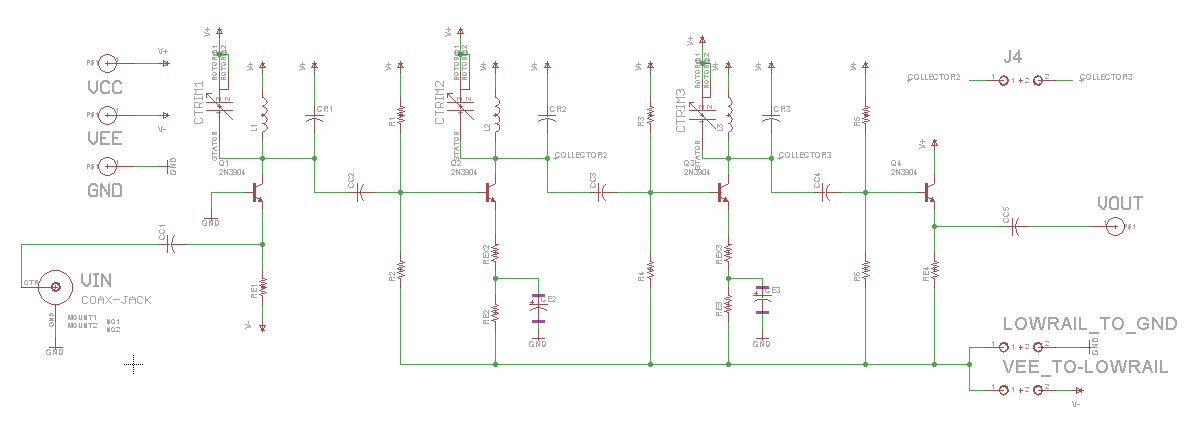
images/multiStageEagleCircuit.PNG
