benlorenzetti/2015-01-28-Multi-Stage-Tuned-Amplifier/images/multiStageF0.png

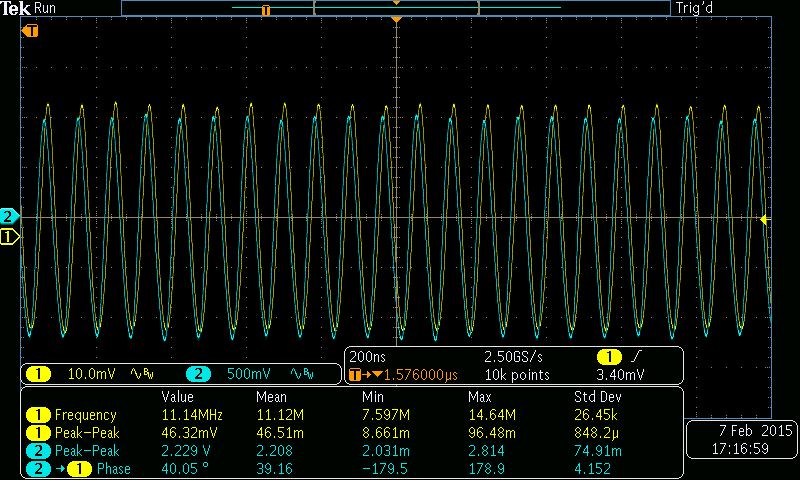
images/multiStageF0.png
