benlorenzetti/2015-01-28-Multi-Stage-Tuned-Amplifier/MATLAB/AvQptRelationship.png

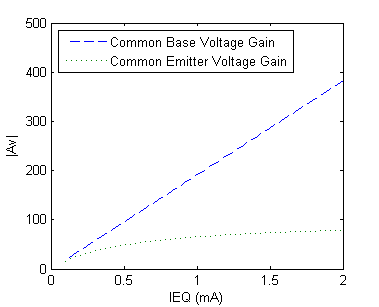
MATLAB/AvQptRelationship.png
