benlorenzetti/2015-01-28-Multi-Stage-Tuned-Amplifier/images/assembledAmplifier.jpeg

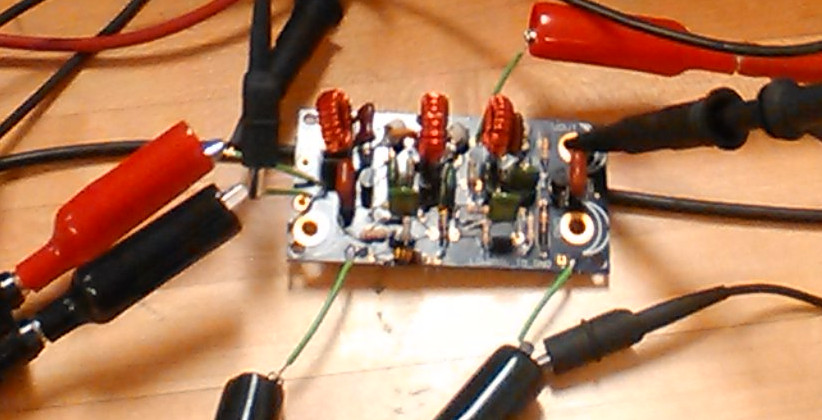
images/assembledAmplifier.jpeg
