benlorenzetti/2015-01-28-Multi-Stage-Tuned-Amplifier/measurements/multiStageResultPlots.xlsx

frequency | db(v(out)/v(in)) | ph(v(out))-ph(v(in)) | Frequency | Vin (pk-pk) | Vout (pk-pk) | Gain | Gain dB
10000 | -186.603 | 2.01776 | 11085000 | 0.0476 | 2.5 | 52.5210084 | 34.40666112
12589.3 | -175.804 | 1.86421 | 11090000 | 0.0486 | 2.6 | 53.49794239 | 34.56674157
15848.9 | -165.256 | 1.6975 | 11095000 | 0.0496 | 2.6 | 52.41935484 | 34.38983343
19952.6 | -154.952 | 1.51973 | 11100000 | 0.0505 | 2.54 | 50.2970297 | 34.03084677
25118.9 | -144.887 | 1.3307 | 11105000 | 0.0487 | 2.79 | 57.28952772 | 35.16150484
31622.8 | -135.068 | 1.1285 | 11110000 | 0.0502 | 3.14 | 62.5498008 | 35.92451862
39810.7 | -125.523 | 0.91092 | 11115000 | 0.048 | 3.18 | 66.25 | 36.42371765
50118.7 | -116.302 | 0.677207 | 11120000 | 0.048 | 2.79 | 58.125 | 35.28725932
63095.7 | -107.468 | 0.429755 | 11125000 | 0.05 | 2.9 | 58 | 35.26855987
79432.8 | -99.0764 | 0.174956 | 11120000 | 0.047 | 2.81 | 59.78723404 | 35.53216924
100000 | -91.1529 | -0.0775049 | 11140000 | 0.05 | 2.98 | 59.6 | 35.50492519
125893 | -83.6823 | -0.31697 | 11150000 | 0.048 | 2.78 | 57.91666667 | 35.25607117
158489 | -76.6097 | -0.53461 | 11160000 | 0.049 | 2.9 | 59.18367347 | 35.44403836
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
