benlorenzetti/2015-01-28-Multi-Stage-Tuned-Amplifier/measurements/cbFrequencyResponse.ods

 | Target Freq. | Frequency | Vin (pk-pk) | Vout (pk-pk) | 1->2 Phase | Gain | Gain dB |  | Targeted 3dB: | 24.0882529855
1 | 5.36E+006 | 5.36E+006 | 0.320 | 0.54 | -20.00 | 1.69 | 4.54 | 24.091128035
2 | 5.74E+006 | 5.74E+006 | 0.328 | 0.46 | -16.00 | 1.40 | 2.94 | 8.7691706047 | 10
3 | 6.16E+006 | 6.16E+006 | 0.328 | 0.40 | -153.00 | 1.22 | 1.72
4 | 6.60E+006 | 6.60E+006 | 0.328 | 0.42 | -51.00 | 1.28 | 2.15
5 | 7.07E+006 | 7.07E+006 | 0.328 | 0.48 | -90.00 | 1.46 | 3.31
6 | 7.58E+006 | 7.58E+006 | 0.328 | 0.50 | -75.00 | 1.51 | 3.59
7 | 8.12E+006 | 8.12E+006 | 0.328 | 0.61 | -84.00 | 1.85 | 5.36
8 | 8.71E+006 | 8.71E+006 | 0.320 | 1.24 | -66.00 | 3.88 | 11.77
9 | 9.33E+006 | 9.33E+006 | 0.320 | 3.00 | -80.00 | 9.38 | 19.44
10 | 1.00E+007 | 1.00E+007 | 0.328 | 1.32 | 104.00 | 4.02 | 12.09
11 | 1.07E+007 | 1.07E+007 | 0.320 | 0.76 | 84.00 | 2.38 | 7.51
12 | 1.15E+007 | 1.15E+007 | 0.328 | 0.44 | 81.00 | 1.34 | 2.55
13 | 1.23E+007 | 1.23E+007 | 0.328 | 0.30 | 89.00 | 0.90 | -0.89
14 | 1.32E+007 | 1.32E+007 | 0.336 | 0.25 | 96.00 | 0.74 | -2.64
15 | 1.41E+007 | 1.41E+007 | 0.328 | 0.20 | 127.00 | 0.62 | -4.12
16 |  | 9.50E+006 | 0.364 | 12.40 | 41.00 | 34.07 | 30.65
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
