benlorenzetti/2015-01-28-Multi-Stage-Tuned-Amplifier/measurements/ceFrequencyResponse.ods

Frequency | Vin (pk-pk) | Vout (pk-pk) | 1->2 Phase | Gain | Gain dB
1.170E+7 | 0.124 | 11.2 | -93 | 90.3225806452 |  | 63.6396103068
1.175E+7 | 0.142 | 10 | -91 | 70.4225352113 |  | 7.891311678
1.112E+7 | 0.396 | 8.2 | 107 | 20.7070707071 |  | 4.880952381
1.100E+7 | 0.372 | 5.6 | 111 | 15.0537634409 |  | 5.1219512195
1.090E+7 | 0.356 | 4.6 | 109 | 12.9213483146 |  | 5.6962025316
1.080E+7 | 0.344 | 4.08 | 110 | 11.8604651163 |  | 6.4383561644
1.070E+7 | 0.34 | 3.6 | 107 | 10.5882352941 |  | 6.8055555556
1.060E+7 | 0.332 | 0.312 | 103 | 0.9397590361
1.050E+7 | 0.328 | 2.8 | 100 | 8.5365853659
1.040E+7 | 0.324 | 2.48 | 98 | 7.6543209877
1.030E+7 | 0.32 | 2.32 | 100 | 7.25
1.020E+7 | 0.312 | 2.2 | 102 | 7.0512820513
1.010E+7 | 0.312 | 2.04 | 103 | 6.5384615385
1.000E+7 | 0.308 | 1.8 | 105 | 5.8441558442
9.500E+6 | 0.304 | 1.38 | 96 | 4.5394736842
9.000E+6 | 0.304 | 1.2 | 100 | 3.9473684211
1.200E+7 | 0.204 | 5.6 | -87 | 27.4509803922
1.250E+7 | 0.244 | 2.88 | -79 | 11.8032786885
