benlorenzetti/2015-01-28-Multi-Stage-Tuned-Amplifier/measurements/multiStageFrequencyResponse.ods

Frequency | Vin (pk-pk) | Vout (pk-pk) | Gain | Gain dB
1.1085E+7 | 0.0476 | 2.5 | 52.5210084034 | 34.406661119
1.1090E+7 | 0.0486 | 2.6 | 53.4979423868 | 34.5667415742
1.1095E+7 | 0.0496 | 2.6 | 52.4193548387 | 34.3898334296
1.1100E+7 | 0.0505 | 2.54 | 50.297029703 | 34.03084677
1.1105E+7 | 0.0487 | 2.79 | 57.2895277207 | 35.1615048412
1.1110E+7 | 0.0502 | 3.14 | 62.5498007968 | 35.9245186186
1.1115E+7 | 0.048 | 3.18 | 66.25 | 36.4237176522
1.1120E+7 | 0.048 | 2.79 | 58.125 | 35.287259318
1.1125E+7 | 0.05 | 2.9 | 58 | 35.2685598713
1.1120E+7 | 0.047 | 2.81 | 59.7872340426 | 35.5321692394
1.1140E+7 | 0.05 | 2.98 | 59.6 | 35.5049251948
1.1150E+7 | 0.048 | 2.78 | 57.9166666667 | 35.2560711708
1.1160E+7 | 0.049 | 2.9 | 59.1836734694 | 35.4440383574
1.1200E+7 | 0.051 | 2.7 | 52.9411764706 | 34.4758717612
1.1300E+7 | 0.049 | 2.1 | 42.8571428571 | 32.6404642941
1.1400E+7 | 0.047 | 1.6 | 34.0425531915 | 30.6404424944
1.1500E+7 | 0.045 | 0.6 | 13.3333333333 | 22.4987747322
1.1600E+7 | 0.046 | 0.447 | 9.7173913043 | 19.750993829
1.1700E+7 | 0.047 | 0.234 | 4.9787234043 | 13.9423599895
1.1000E+7 | 0.051 | 1.7 | 33.3333333333 | 30.4575749056
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
