benlorenzetti/2015-01-28-Multi-Stage-Tuned-Amplifier/measurements/multiStageResultsMag.png

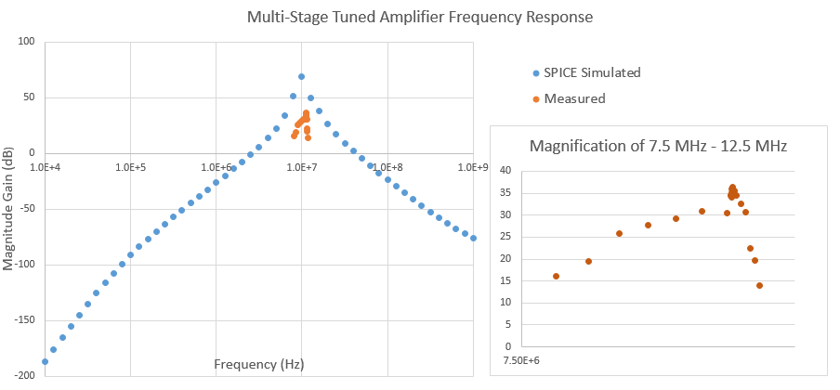
measurements/multiStageResultsMag.png
