benlorenzetti/2015-01-28-Multi-Stage-Tuned-Amplifier/measurements/multiStageResultsPhase.png

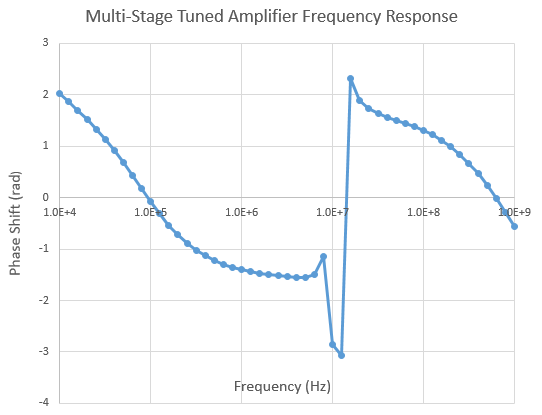
measurements/multiStageResultsPhase.png
