benlorenzetti/2015-01-28-Multi-Stage-Tuned-Amplifier/measurements/q1Characteristics.png

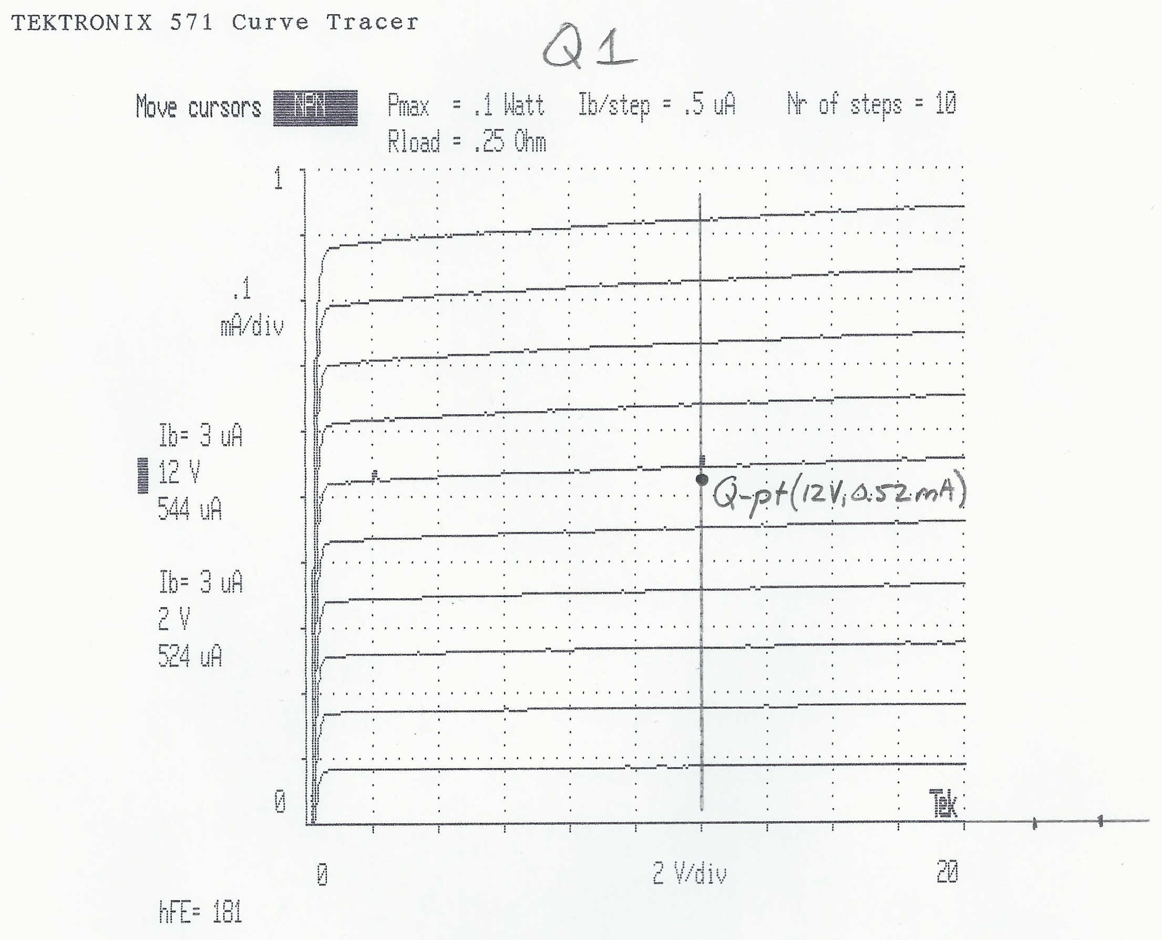
measurements/q1Characteristics.png
