benlorenzetti/2015-01-28-Multi-Stage-Tuned-Amplifier/measurements/q2Characteristics.png

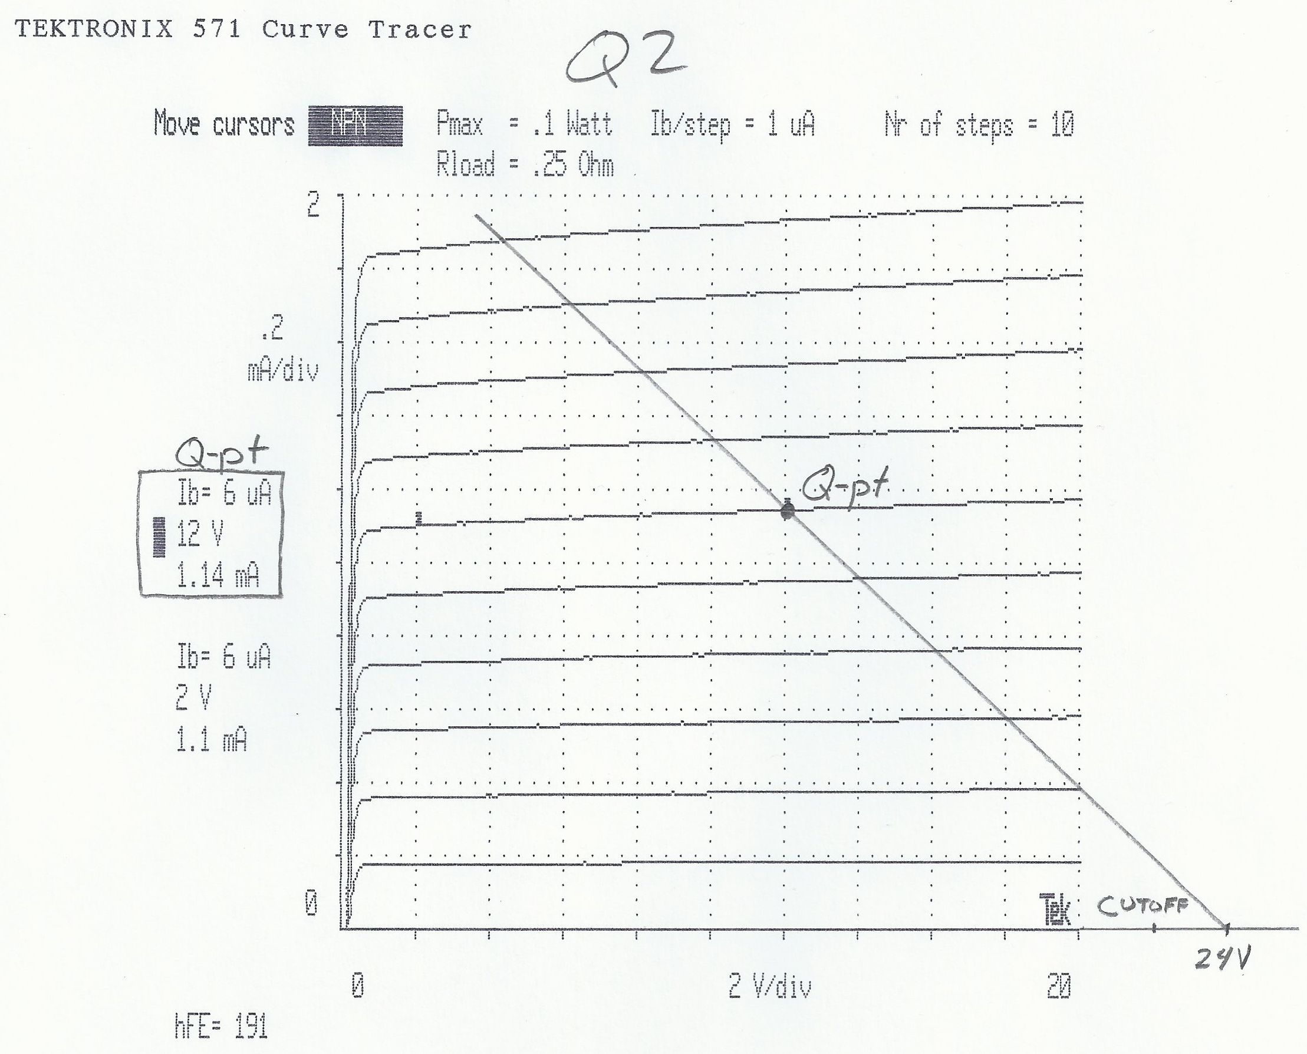
measurements/q2Characteristics.png
