benlorenzetti/2015-01-28-Multi-Stage-Tuned-Amplifier/mathGL/cbStage-eps-converted-to.pdf

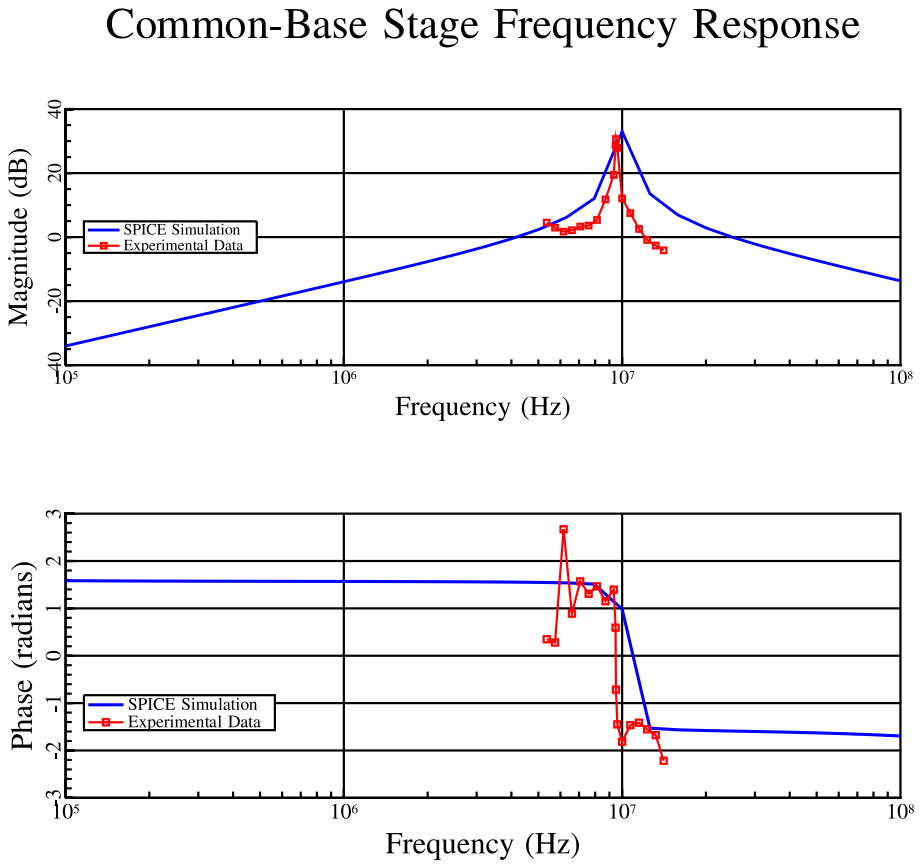
[picture p42: page 1]
