benlorenzetti/2015-01-28-Multi-Stage-Tuned-Amplifier/mathGL/ceStage-eps-converted-to.pdf

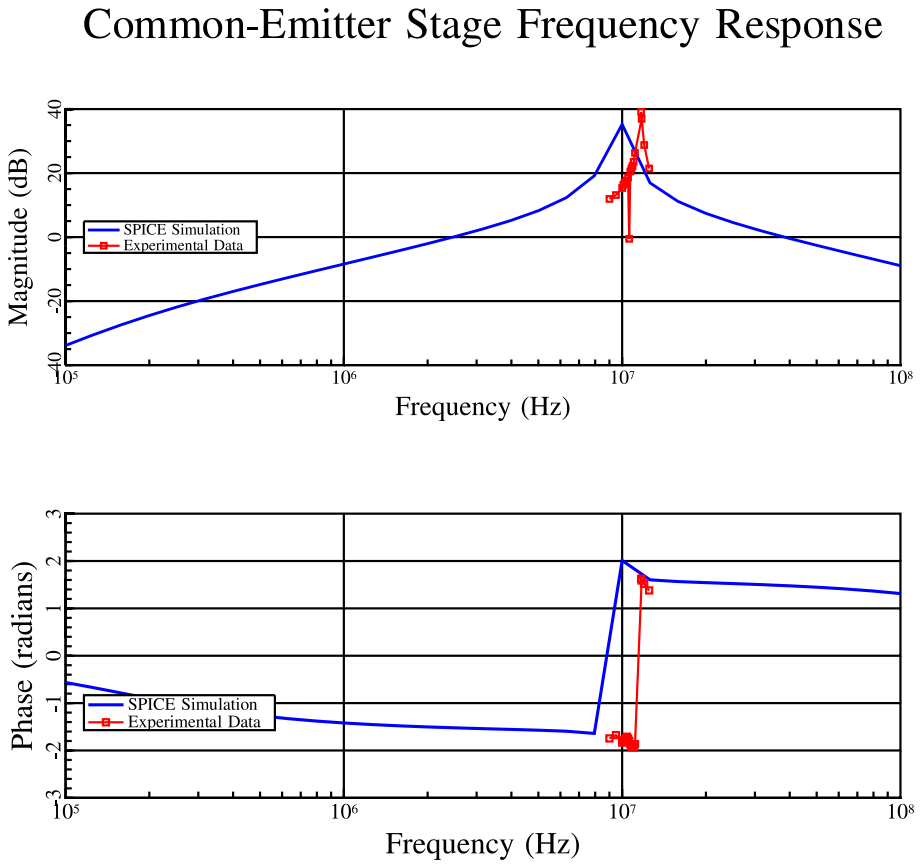
[picture p43: page 1]
