benlorenzetti/2015-01-28-Multi-Stage-Tuned-Amplifier/(commit log)

2015-01-30 added circuit diagrams for CB, CE, CC, and 3-stage
2015-02-01 tank circuit theory and hp q meter
2015-02-02 tank circuit 1 design
2015-02-03 tank circuit theory, tank table, and remaining theory diagrams
2015-02-05 updated stage 1&2 design and added Q1-4 characteristics
2015-02-05 stage 2 and stage 3 component values
2015-02-09 CB+CE SPICE+data and passive components table
    [CBstage.csv, CEstage.csv, cbFrequencyResponse.csv, ceFrequencyResponse.csv, multiStage.csv]
2015-02-09 building the circuit
2015-02-09 results and conclusions
    [multiStageResultPlots.xlsx]
